Roel1983/RGBW-Bar/README.md

# RGBW-Bar

Work in progress

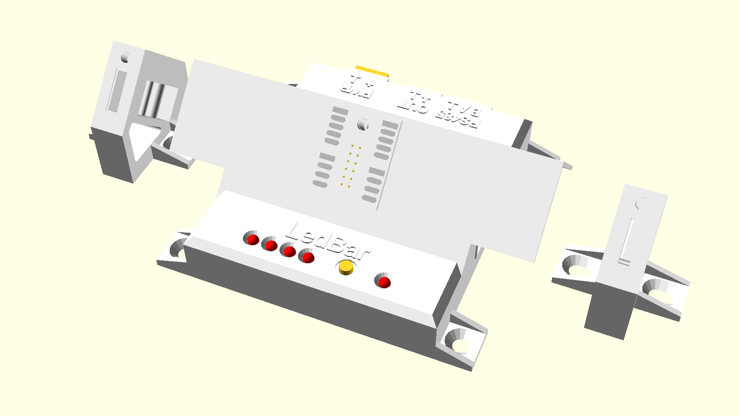
[picture p1: Devices/LedBar/3D/LedBar/LedBar.png]
Case
