Roel1983/RGBW-Bar/Devices/LedBar/3D/LedBar/Case.png

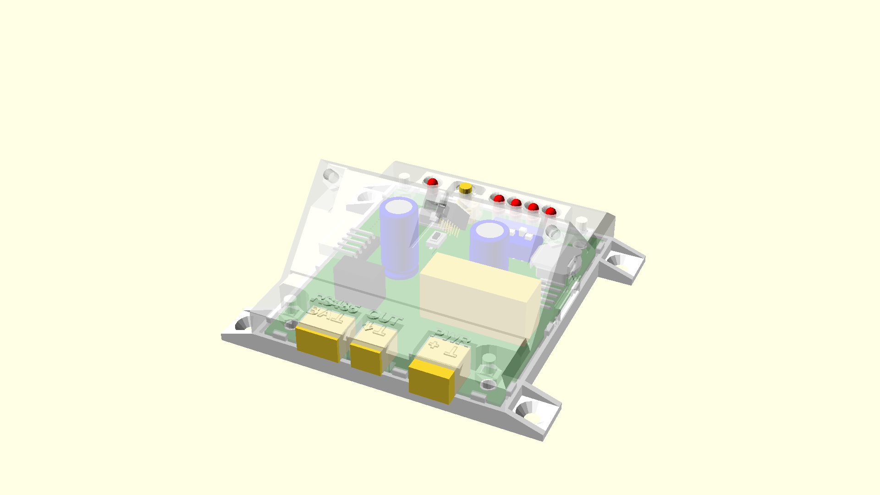
Devices/LedBar/3D/LedBar/Case.png
