Roel1983/RGBW-Bar/Devices/LedBar/3D/LedBar/Case/Shared/Boards/Mainboard/Mainboard.scad

use     <../../../../../../../Shared/3D/Utils/Box.scad>
use     <../../Footprint/Footprint.scad>
use     <../../PlaceFootprints.scad>

include <MainboardKicadPcb.inc>

$fn = 32;
Mainboard();

module Mainboard() {
    MainboardEdgeCuts();
    PlaceFootprints(ALL_COMPONENTS_MAINBOARD, "3D", PCB_THICKNESS_MAINBOARD);
}

module MainboardEdgeCuts() {
    color("green")linear_extrude(PCB_THICKNESS_MAINBOARD) {
        MainboardEdgeCuts2D();
    }
}

module MainboardEdgeCuts2D() {
    difference() {
        Box(bounds = PCB_BOUNDS_MAINBOARD);
        PlaceFootprints(ALL_COMPONENTS_MAINBOARD, "Edge.Cuts");
    }
}
