Roel1983/RGBW-Bar/Devices/LedBar/3D/LedBar/Case/Shared/Footprint/Connector_PinHeader_2_00mm/PinHeader_1x6_P2_00mm_Vertical.scad

include <../../../../Config.inc>

use     <../../../../../../../Shared/3D/Utils/Box.scad>

$fn = 32;

PinHeader_1x6_P2_00mm_Vertical(layer = "3D");

module PinHeader_1x6_P2_00mm_Vertical(layer) {
    if (layer == "3D") {
        Layer3D();
    } else if(layer == "Profile.Remove") {
        LayerProfileRemove();
    }
    pitch = mm(2.00);
    
    module Layer3D() {
        color([.1,.1,.1]) {
            Box(
                x_from = mm(-2.25/2),
                x_size = mm(2.25),
                y_to   = mm(1.25),
                y_size = mm(12.5),
                z_to   = mm(1.5)
            );
        }
        for(y =[-5:0]) {
            translate([0, y * pitch]) {
                Pin();
            }
        }
        
        module Pin() {
            Box(
                x_size = mm(.5),
                y_size = mm(.5),
                z_from = mm(-2.5),
                z_to   = mm(5.5)
            );
        }
    }
    module LayerProfileRemove() {
        BIAS = 0.01;
        Box(
            x_from = mm(-2.25/2),
            x_size = mm(2.25),
            y_to   = mm(1.25),
            y_size = mm(12.5),
            z_from = -BIAS,
            z_to   = mm(1.5)
        );
    }
}
