Roel1983/RGBW-Bar/Devices/LedBar/3D/LedBar/Case/Shared/Footprint/RGBW-Bar/PinHeader_2x06_P200mm_PCB_edge.scad

include <../../../../../../../Shared/3D/Utils/Constants.inc>
include <../../../../Config.inc>
include <../../Boards/Subboards/SubboardsKicadPcb.inc>

use <../Connector_PinHeader_2_00mm/PinHeader_2x6_P2_00mm_Horizontal.scad>

$fn = 32;

PinHeader_2x06_P200mm_PCB_edge(layer = "3D");

module PinHeader_2x06_P200mm_PCB_edge(layer, pins = 3) {
    pitch = mm(2);
    translate([0,0, -pitch / 2 - PCB_THICKNESS_SUBBOARDS / 2])
    rotate(-90, VEC_Y) {
        PinHeader_2x6_P2_00mm_Horizontal(layer);
    }
}
