Roel1983/RGBW-Bar/Devices/Shared/3D/Utils/Hex.scad

Hex(10);

module Hex(size = 1) {
    intersection_for(a=[0:120:359]) rotate(a) {
        square([size, 2 * size], true);
    }
}
