Roel1983/RGBW-Bar/Devices/Shared/3D/Utils/Optional.scad

function optional(o, def) = is_undef(o) ? def : o;

assert(optional(undef,      "default") == "default");
assert(optional("my_value", "default") == "my_value");
