Roel1983/RGBW-Bar/Devices/Shared/3D/Utils/TransformCopy.scad

module mirror_copy(vec) {
    children();
    mirror(vec) children();
}
