Roel1983/RGBW-Bar/Devices/LedBar/3D/LedBar/Support/EndSupportAngle45.scad

use <EndSupportStraight.scad>

EndSupportAngle45();

module EndSupportAngle45() {
    EndSupportStraight(45);
}
