Roel1983/RGBW-Bar/Devices/LedBar/3D/LedBar/Case/Shared/Footprint/Button_Switch_SMD/Button_Switch_SMD.scad

use <SW_SPST_CK_RS282G05A3.scad>

module Button_Switch_SMD(layer, footprint) {
    if(footprint == "SW_SPST_CK_RS282G05A3") {
        SW_SPST_CK_RS282G05A3(layer = layer);
    }
}
