Roel1983/RGBW-Bar/Devices/LedBar/3D/LedBar/Case/Shared/Footprint/Button_Switch_SMD/SW_SPST_CK_RS282G05A3.scad

use     <../../../../../../../Shared/3D/Utils/Units.scad>

SW_SPST_CK_RS282G05A3(layer = "3D");

module SW_SPST_CK_RS282G05A3(layer) {
    if (layer == "3D") {
        Layer3D();
    }
    
    module Layer3D() {
        color("silver") {
            linear_extrude(mm(0.15)) square(mm([8.0, nozzle(2)]), center=true);
            linear_extrude(mm(1.35)) square(mm([6.0, 3.6]), center=true);
            linear_extrude(mm(1.70)) square(mm([4.0, 2.0]), center=true);
        }
        color([0.1,0.1,0.1]) {
            linear_extrude(mm(2.30)) square(mm([2.65, 1.3]), center=true);
        }
    }
}
