Roel1983/RGBW-Bar/Devices/LedBar/3D/LedBar/Case/Shared/Footprint/Button_Switch_THT/Button_Switch_THT.scad

use <../../../../../../../Shared/3D/Utils/Units.scad>

use <SW_DIP_SPSTx05_Slide_6_7x14_26mm_W7_62mm_P2_54mm_LowProfile.scad>
use <SW_PUSH_6mm.scad>

module Button_Switch_THT(layer, footprint) {
    if(footprint == "SW_PUSH_6mm_H8mm") {
        SW_PUSH_6mm(layer = layer, H=mm(10.0));
    } else if(footprint == "SW_DIP_SPSTx05_Slide_6.7x14.26mm_W7.62mm_P2.54mm_LowProfile") {
        SW_DIP_SPSTx05_Slide_6_7x14_26mm_W7_62mm_P2_54mm_LowProfile(layer = layer, channels = 5);
    }
}
