Roel1983/RGBW-Bar/Devices/LedBar/3D/LedBar/Case/Shared/Footprint/Capacitor_SMD/Capacitor_SMD.scad

use <C_0805_2012Metric_Pad1_18x1_45mm_HandSolder.scad>

module Capacitor_SMD(layer, footprint) {
    if(footprint == "C_0805_2012Metric_Pad1.18x1.45mm_HandSolder") {
        C_0805_2012Metric_Pad1_18x1_45mm_HandSolder(layer);
    }
}
