Roel1983/RGBW-Bar/Devices/LedBar/3D/LedBar/Case/Shared/Footprint/Connector_PinHeader_2_00mm/RGBW_wire_solder_pads.scad

use     <../../../../../../../Shared/3D/Utils/Box.scad>
use     <../../../../../../../Shared/3D/Utils/Units.scad>

RGBW_wire_solder_pads(layer = "3D", side = "R");

module RGBW_wire_solder_pads(layer, side) {
    if (layer == "3D") {
        Layer3D();
    }
    
    module Layer3D() {
        color("silver") {
            pitch = mm(2.0);
            linear_extrude(layer(1)) {
                PinRectangle();
                for(i=[1:4]) translate([0, -i * pitch]) {
                    PinOval();
                }
            }
        }
        
        module PinRectangle() {
            Box(x_size = mm(4.05), y_size = mm(1.4));
        }
        
        module PinOval() {
            hull() {
                translate([-mm((4.05 - 1.4) / 2 ), 0]) circle(d=mm(1.4));
                translate([ mm((4.05 - 1.4) / 2 ), 0]) circle(d=mm(1.4));
            }
        }
    }
}
