Roel1983/RGBW-Bar/Devices/LedBar/3D/LedBar/Case/Shared/Footprint/Crystal/Crystal_C38_LF_Horizontal_1EP_style1.scad

include <../../../../../../../Shared/3D/Utils/Constants.inc>
use     <../../../../../../../Shared/3D/Utils/Units.scad>
$fn = 32;

Crystal_C38_LF_Horizontal_1EP_style1(layer = "3D", D=mm(3.0), L=mm(8.0));

module Crystal_C38_LF_Horizontal_1EP_style1(layer, D=mm(3.0), L=mm(8.0)) {
    if (layer == "3D") {
        Layer3D();
    }
    
    module Layer3D() {
        color("silver") {
            pitch = mm(1.9);
            translate([0, mm(-2.3), D/2])
            rotate(90, VEC_X) cylinder(d=D, h=L);
        }
    }
}
