Roel1983/RGBW-Bar/Devices/LedBar/3D/LedBar/Case/Shared/Footprint/Diode_SMD/Diode_SMD.scad

use     <../../../../../../../Shared/3D/Utils/Units.scad>

use <D_SMB_Handsoldering.scad>

module Diode_SMD(layer, footprint) {
    if(footprint == "D_SMB_Handsoldering") {
        D_SMB_Handsoldering(layer = layer);
    }
}
