Roel1983/RGBW-Bar/Devices/LedBar/3D/LedBar/Case/Shared/Footprint/Jumper/Jumper.scad

use     <../../../../../../../Shared/3D/Utils/Units.scad>

use <SolderJumper_3_P1_3mm_Open_Pad1_0x1_5mm.scad>

module Jumper(layer, footprint) {
    if(footprint == "SolderJumper-3_P1.3mm_Open_Pad1.0x1.5mm") {
        SolderJumper_3_P1_3mm_Open_Pad1_0x1_5mm(layer = layer);
    }
}
