Roel1983/RGBW-Bar/Devices/LedBar/3D/LedBar/Case/Shared/Footprint/MountingHole/MountingHole.scad

use <MountingHole_4_3mm_M4.scad>

module MountingHole(layer, footprint) {
    if(footprint == "MountingHole_4.3mm_M4") {
        MountingHole_4_3mm_M4(layer = layer);
    }
}
