Roel1983/RGBW-Bar/Devices/LedBar/3D/LedBar/Case/Shared/Footprint/MountingHole/MountingHole_4_3mm_M4.scad

use     <../../../../../../../Shared/3D/Utils/Units.scad>

MountingHole_4_3mm_M4(layer = "Edge.Cuts");

module MountingHole_4_3mm_M4(layer) {
    if(layer == "Edge.Cuts") {
        EdgeCuts();
    }
    
    module EdgeCuts() {
        circle(d = mm(4.3));
    }
}
