Roel1983/RGBW-Bar/Devices/LedBar/3D/LedBar/Case/Shared/Footprint/Resistor_SMD/R_0805_2012Metric_Pad1_20x1_40mm_HandSolder.scad

use     <../../../../../../../Shared/3D/Utils/Units.scad>

use <R_HandSolder.scad>

R_0805_2012Metric_Pad1_20x1_40mm_HandSolder("3D");

module R_0805_2012Metric_Pad1_20x1_40mm_HandSolder(layer = "3D") {
    R_HandSolder(
        layer = layer,
        l = inch(0.08),
        w = inch(0.05),
        h = mm(0.45),
        
        solder_l = mm(3.2),
        solver_w = mm(1.4)
    );
}
