Roel1983/RGBW-Bar/Devices/LedBar/3D/LedBar/Case/Shared/Footprint/Resistor_SMD/R_1210_3225Metric_Pad1_30x2_65mm_HandSolder.scad

use     <../../../../../../../Shared/3D/Utils/Units.scad>

use <../Shared/SMD_HandSolder.scad>

R_1210_3225Metric_Pad1_30x2_65mm_HandSolder("3D");

module R_1210_3225Metric_Pad1_30x2_65mm_HandSolder(layer = "3D") {
    SMD_HandSolder(
        layer = layer,
        l = inch(0.12),
        w = inch(0.10),
        h = mm(0.55),
        
        solder_l = mm(1.55 * 2 + 1.3) ,
        solder_w = mm(2.65)
    );
}
