Roel1983/RGBW-Bar/(list of files, cad)

Other CAD files:
Devices/LedBar/3D/LedBar/Case/Shared/Footprint/Connector_PinHeader_2_00mm/PinHeader_2x6_P2_00mm_Vertical.scad
Devices/Shared/3D/Utils/Shapes.scad
Devices/LedBar/3D/LedBar/Support/MiddleSupport.scad
Devices/LedBar/3D/LedBar/Support/MiddleSupportTemplate.scad
Devices/LedBar/3D/LedBar/Case/Shared/Footprint/RGBW-Bar/15EDGRC_3_5.scad
Devices/LedBar/3D/LedBar/Case/Shared/Footprint/RGBW-Bar/2EDGRC_5_08_2P.scad
Devices/LedBar/3D/LedBar/Case/Shared/Footprint/RGBW-Bar/B0505S_1W.scad
Devices/LedBar/3D/LedBar/Case/Shared/Footprint/RGBW-Bar/Color_wire_solder_pads.scad
Devices/LedBar/3D/LedBar/Case/Shared/Footprint/RGBW-Bar/Fuseholder_Cylinder_5x20mm_BLX_A_Horizontal.scad
Devices/LedBar/3D/LedBar/Case/Shared/Footprint/RGBW-Bar/ISP_single_row.scad
Devices/LedBar/3D/LedBar/Case/Shared/Footprint/RGBW-Bar/MountingHole_3_2mm_Wall_0_8mm.scad
Devices/LedBar/3D/LedBar/Case/Shared/Footprint/RGBW-Bar/MountingHole_4_3mm_M4_modified1.scad
Devices/LedBar/3D/LedBar/Case/Shared/Footprint/RGBW-Bar/Perpendicular_pcb_1mm_female_2x6.scad
Devices/LedBar/3D/LedBar/Case/Shared/Footprint/RGBW-Bar/RGBW-Bar.scad
Devices/LedBar/3D/LedBar/Case/Shared/Footprint/RGBW-Bar/TestPoint_Pad.scad
Devices/LedBar/3D/LedBar/Case/Shared/Footprint/Resistor_SMD/R_HandSolder.scad
Devices/LedBar/3D/LedBar/Case/Shared/Footprint/Resistor_SMD/Resistor_SMD.scad
Devices/LedBar/3D/LedBar/Case/Shared/Footprint/Shared/SMD_HandSolder.scad
