Roel1983/RGBW-Bar/(threads)

Thread 1 (2022-09-15):

Fix color channel order of strips

Roel1983, 2022-09-15:
Should be:

RGB-strip
1 : 12V
2 : B
3 : R
4 : G

RGBW-strip
1 : 12V
2 : R
3 : G
4 : B
5 : W

To minimize crossing lines the main connector:
1 : 12V
2 : R
3 : G
4 : B
5 : W

Roel1983, 2022-10-29:
- [ ] Make sure for the last time we have the order correct now? (Don't trust the Chinese silklayer)
- [ ] Create new foot prints with the correct channel order
- [ ] Make new symbols with the correct channel order for the main connector
- [ ] Rewire the connectors in the schematic
- [ ] Rewire the connectors on the PCB

Roel1983, 2022-10-30:
The left sided RGB(W) connectors are at the right side and visa versa, because they are 180 degrees rotated.

Closed 2022-10-30.

Thread 10 (2022-09-15):

Add clearance around screw holes

Roel1983, 2022-09-15:

Closed 2022-11-17.

Thread 11 (2022-09-15):

PCB: Make 'Left' and 'Right' board identical

Roel1983, 2022-09-15:
By making them identical it is less cost to manufacture.

Roel1983, 2022-11-04:
Just remove reference numbers of silk screen and other silkscreen that is specific for the left versus the right board.

Closed 2022-11-13.

Thread 12 (2022-09-15):

3D: Update case for changes to the PCB

Roel1983, 2022-09-15:
Adjust for change of E.g.:
- [ ] #4
- [ ] perpendicular board shape
- [ ] PCB thickness
- [ ] Holes
- [ ] Feet
- [ ] Wall thickness

Roel1983, 2023-07-25:
N.a. Applies to out-dated version of the case

Closed 2023-07-25.

Thread 2 (2022-09-15):

PCB: Improve brown-out threshold

Roel1983, 2022-09-15:

Roel1983, 2023-07-25:
Done by now

Closed 2023-07-25.

Thread 4 (2022-09-15):

Replace power connector for bigger connector

Roel1983, 2022-09-15:

Roel1983, 2022-10-31:
Replaced connector footprint 15EDGRC-3.5 for 2EDGRC-5.08 connectors.
Updated schematic
Updated PCB

Closed 2022-10-31.

Thread 5 (2022-09-15):

Inverse brown-out LED.

Roel1983, 2022-09-15:

Closed 2022-10-31.

Thread 6 (2022-09-15):

Fix shape of perpendicular board so it corresponds with width of J1002

Roel1983, 2022-09-15:

Roel1983, 2022-11-02:
I measured the connector at 12.5mm width and updated the board-outline by rounding of to 12.57mm
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

Closed 2022-11-02.

Thread 8 (2022-09-15):

Fix 5V power suppy so it doesn't fail dangerously

Roel1983, 2022-09-15:
Suggestions:
- place an series resistor to the LDO
- add optional zener diode
- Use branded LDO instead of Chinees unbranded stuff
- Check data sheet for e.g. type of capacitor to use

Closed 2022-11-01.

Thread 13 (2022-10-30):

Disable LED when at power up until initialization is complete

Roel1983, 2022-10-30:
We need an extra pin that is pulled up and connected to the ~oe~ using a diode.
When the pin is initially an input, the pull-up will raise it. It has to be actively lowered by making it an output and set to LOW. The diode makes it possible the rest of the circuit keeps working.

Roel1983, 2022-10-31:
Pin 'dbg2' is now '~pca_rdy~' is pulled up by an external resistor.
ISP connector is moved downwards to make space for extra components
a GND test-pin pad is moved to other location

Closed 2022-10-31.

Thread 14 (2022-10-31):

3D: Add screw feet to main enclosure

Roel1983, 2022-10-31:
Lets use the screw holes at all corners of the PCB for metric screws to close the enclosure and at feet for the mounting screws.
Rational: no sharp screws that might cut into the PCB. Better closing of the enclosure.

Roel1983, 2023-07-25:
N.a. Applies to out-dated version of the case

Closed 2023-07-25.

Thread 17 (2022-11-02):

3D: Add optional aditional nuts in the enclosure to screw on the profile

Roel1983, 2022-11-02:
Add 2 nuts like already done for securing the center-board and profile with the enclose.
Locate those nuts at either sides and a the other slanted surface as the nut for the center-board.
- [ ] Add nuts to the enclosure
- [ ] Make/update drill fixtures

Roel1983, 2023-07-25:
N.a. Applies to out-dated version of the case

Closed 2023-07-25.

Thread 23 (2022-11-17):

PCB: Fix copper layer unprotected_12VDC

Roel1983, 2022-11-17:

Closed 2022-11-17.

Thread 25 (2023-07-20):

3D: Add more tolerance around LED

Roel1983, 2023-07-20:

Closed 2023-07-20.

Thread 26 (2023-07-20):

3D: Add more tolerance around button

Roel1983, 2023-07-20:

Closed 2023-07-25.

Thread 27 (2023-07-20):

3D: Add tolerance to mainboard PCB thickness

Roel1983, 2023-07-20:

Thread 28 (2023-07-20):

3D: Add more z tolerance to back connectors

Roel1983, 2023-07-20:

Roel1983, 2023-07-31:
Solved

Closed 2023-07-31.

Thread 30 (2023-07-25):

3D: Inner rim to hole for J1005

Roel1983, 2023-07-25:

Roel1983, 2023-07-31:
Solved

Closed 2023-07-31.

Thread 31 (2023-07-27):

3D: Side connector too tight

Roel1983, 2023-07-27:

Roel1983, 2023-07-31:
Solved

Closed 2023-07-31.
