Roel1983/RGBW-Bar/Devices/LedBar/PCB/Release/LedBar.pdf

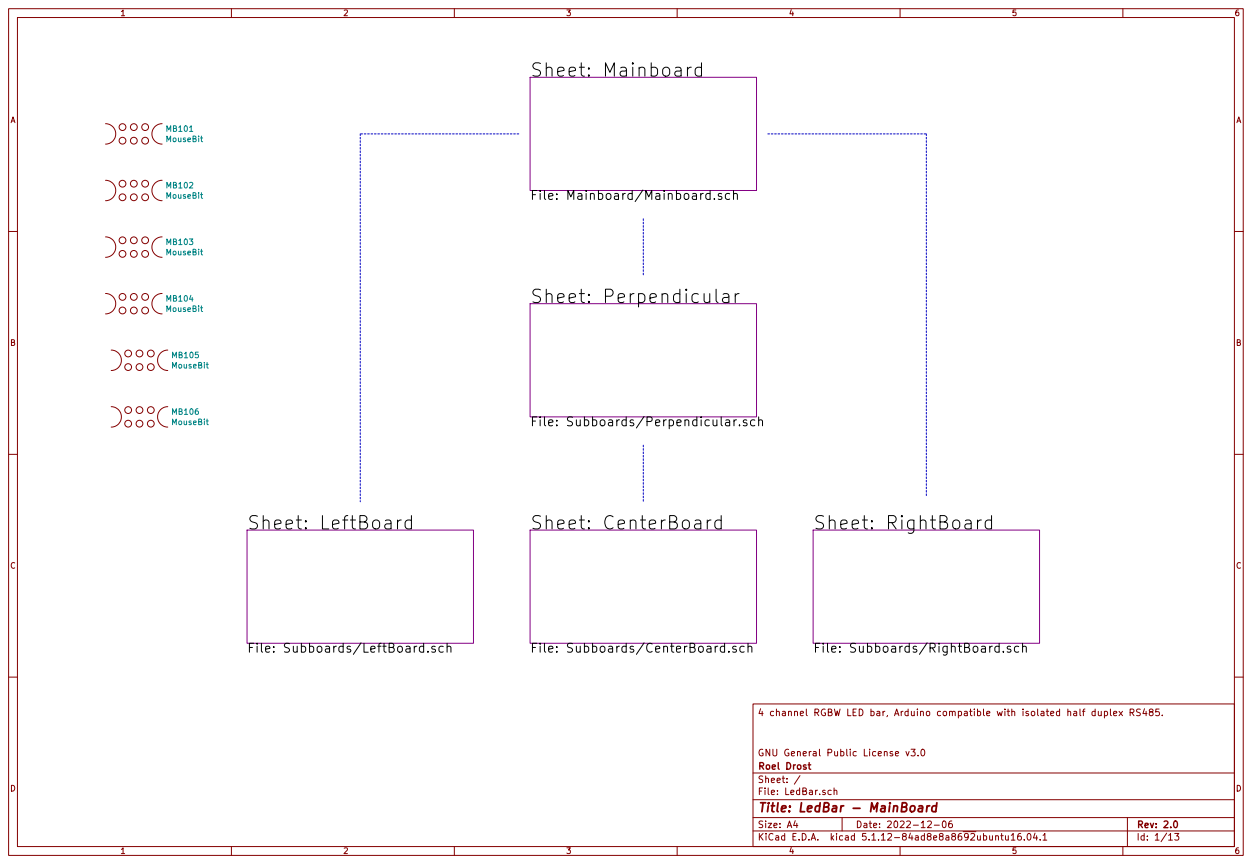
[picture p3: page 1]

MB106 MouseBit MB105 MouseBit MB104 MouseBit MB103 MouseBit MB102 MouseBit MB101 MouseBit

File: Mainboard/Mainboard.sch

File: Subboards/Perpendicular.sch

File: Subboards/LeftBoard.sch

File: Subboards/CenterBoard.sch

File: Subboards/RightBoard.sch

4 channel RGBW LED bar, Arduino compatible with isolated half duplex RS485.

File: LedBar.sch Sheet: / Roel Drost GNU General Public License v3.0

Id: 1/13 Title: LedBar - MainBoard

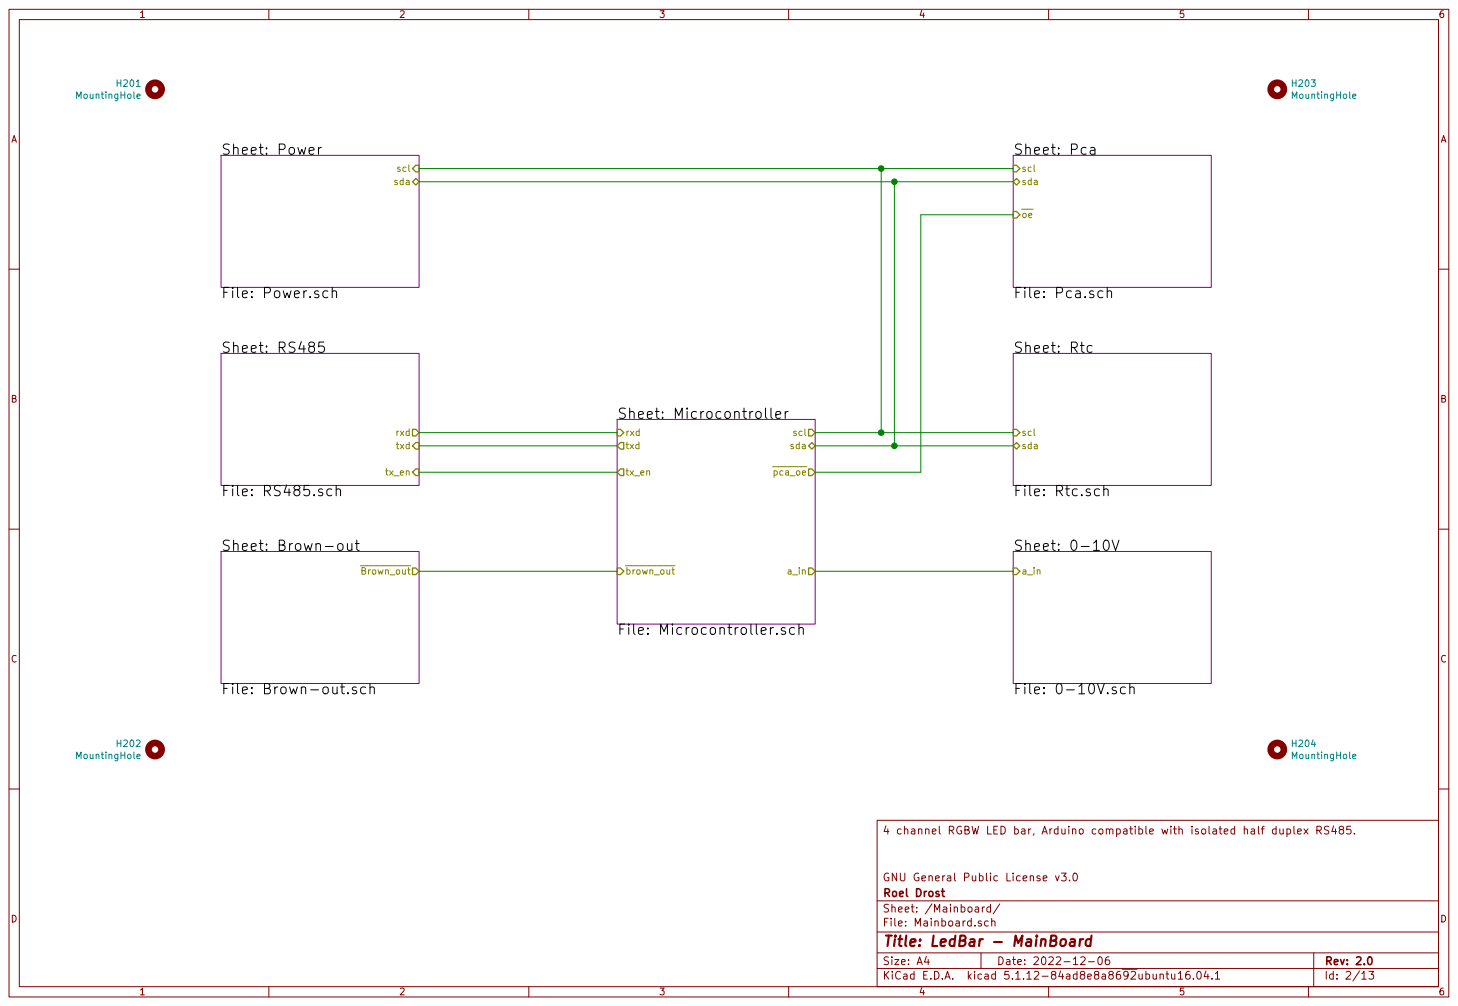
[picture p4: page 2]

File: Brown-out.sch

4 channel RGBW LED bar, Arduino compatible with isolated half duplex RS485.

File: Mainboard.sch Sheet: /Mainboard/ Roel Drost GNU General Public License v3.0

Id: 2/13 Title: LedBar - MainBoard

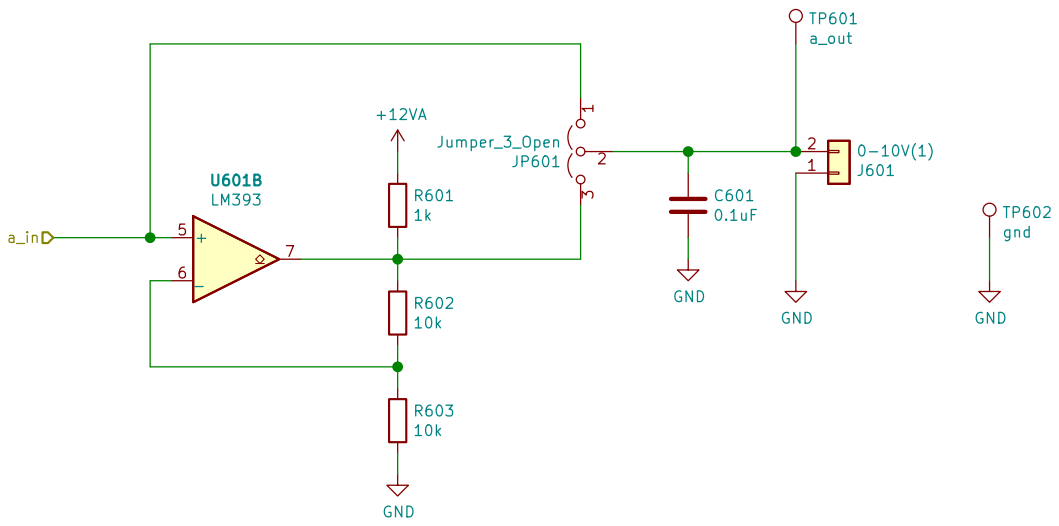
[picture p5: page 3]

4 channel RGBW LED bar, Arduino compatible with isolated half duplex RS485. R601
0.1uF GND

File: 0-10V.sch Sheet: /Mainboard/0-10V/ Roel Drost GNU General Public License v3.0

Id: 3/13 Title: LedBar - MainBoard

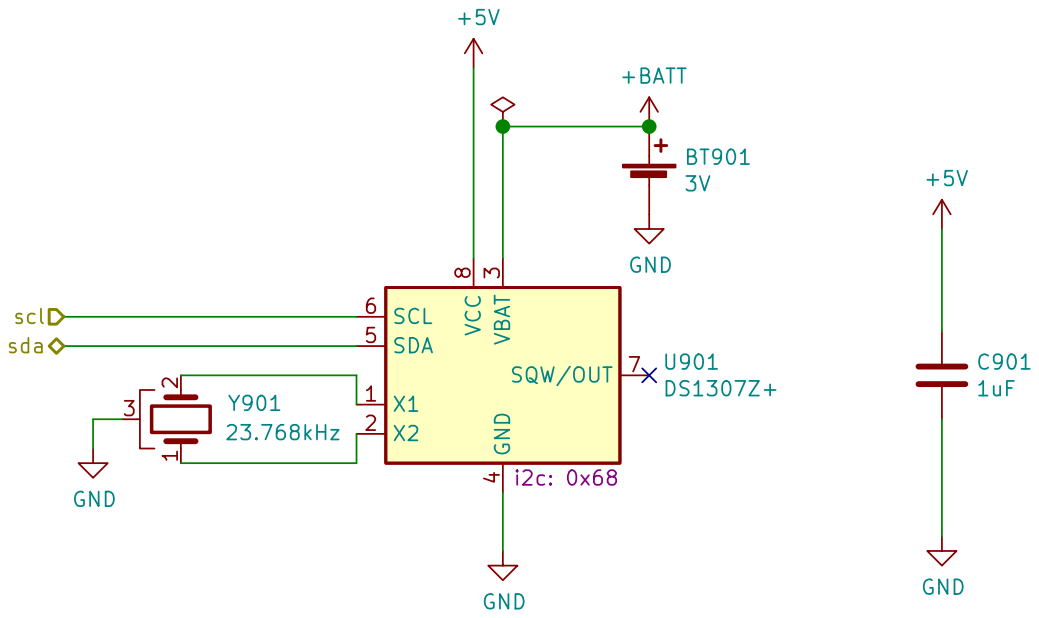
[picture p6: page 4]

4 SDA 5 SCL 6 SQW/OUT 7 VCC

4 channel RGBW LED bar, Arduino compatible with isolated half duplex RS485.

File: Rtc.sch Sheet: /Mainboard/Rtc/ Roel Drost GNU General Public License v3.0

Id: 4/13 Title: LedBar - MainBoard

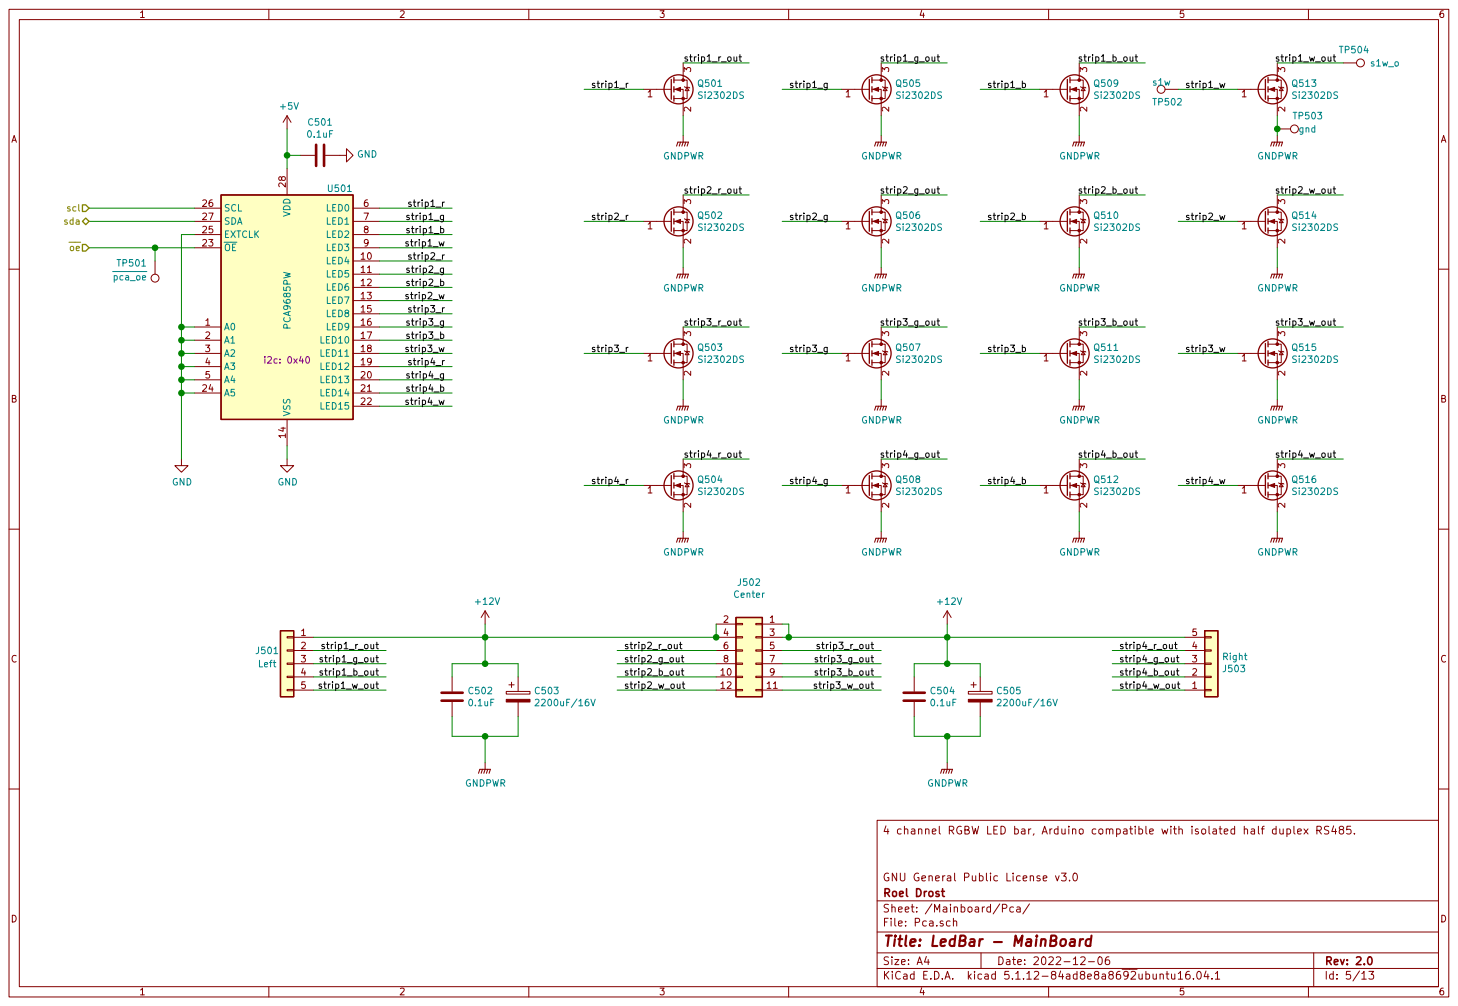
[picture p7: page 5]

4 channel RGBW LED bar, Arduino compatible with isolated half duplex RS485. GNDPWR

File: Pca.sch Sheet: /Mainboard/Pca/ Roel Drost GNU General Public License v3.0

Id: 5/13 Title: LedBar - MainBoard

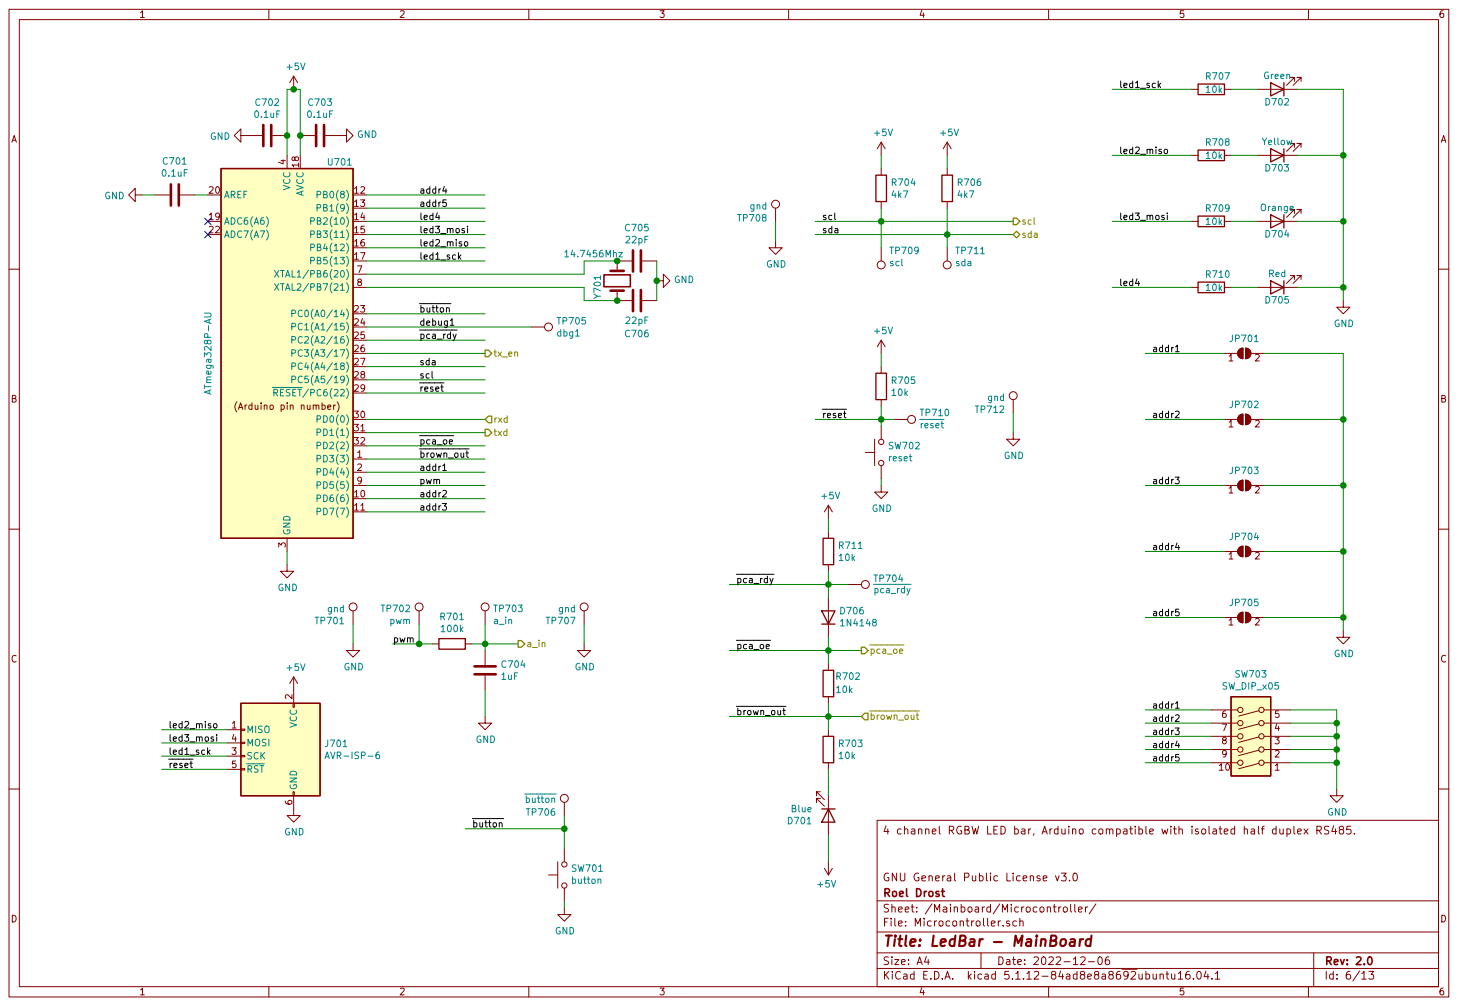
[picture p8: page 6]

4 channel RGBW LED bar, Arduino compatible with isolated half duplex RS485.

File: Microcontroller.sch Sheet: /Mainboard/Microcontroller/ Roel Drost GNU General Public License v3.0

Id: 6/13 Title: LedBar - MainBoard

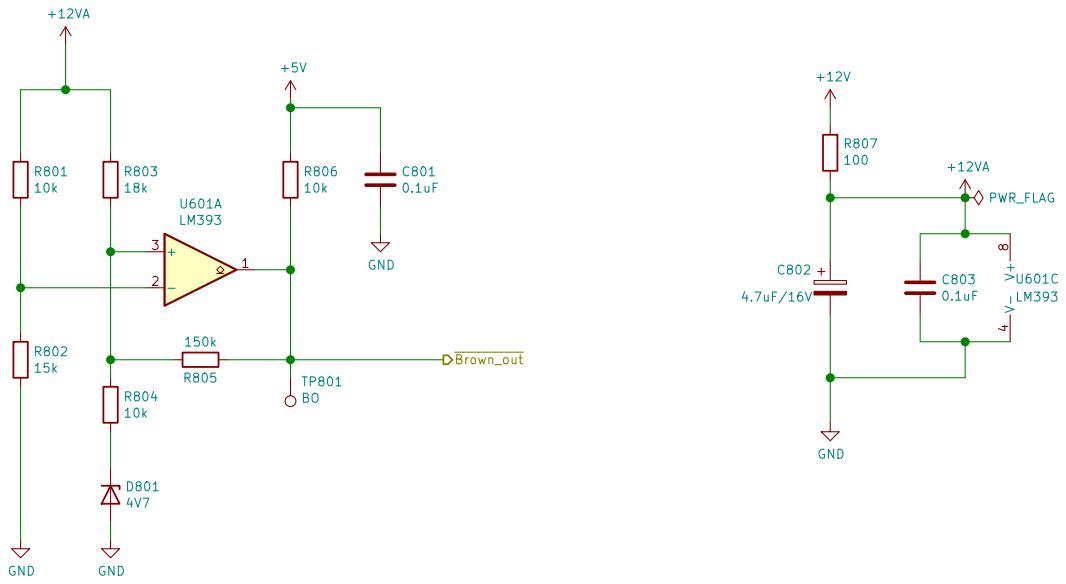
[picture p9: page 7]

4 channel RGBW LED bar, Arduino compatible with isolated half duplex RS485. R807

File: Brown-out.sch Sheet: /Mainboard/Brown-out/ Roel Drost GNU General Public License v3.0

Id: 7/13 Title: LedBar - MainBoard

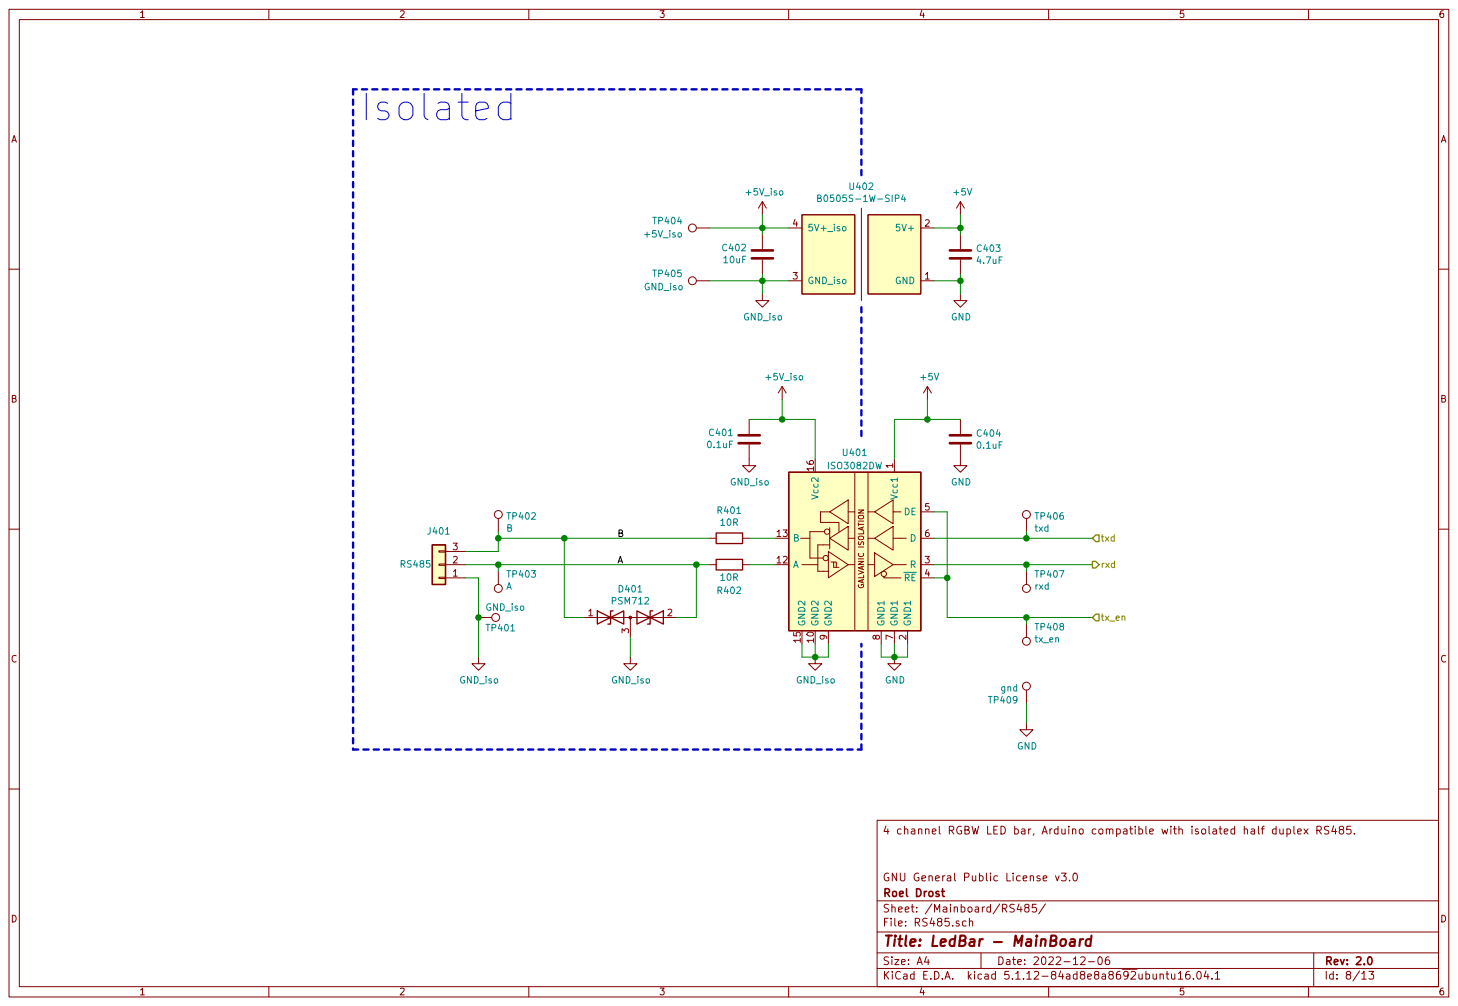
[picture p10: page 8]

File: RS485.sch Sheet: /Mainboard/RS485/ Roel Drost GNU General Public License v3.0

Id: 8/13 Title: LedBar - MainBoard

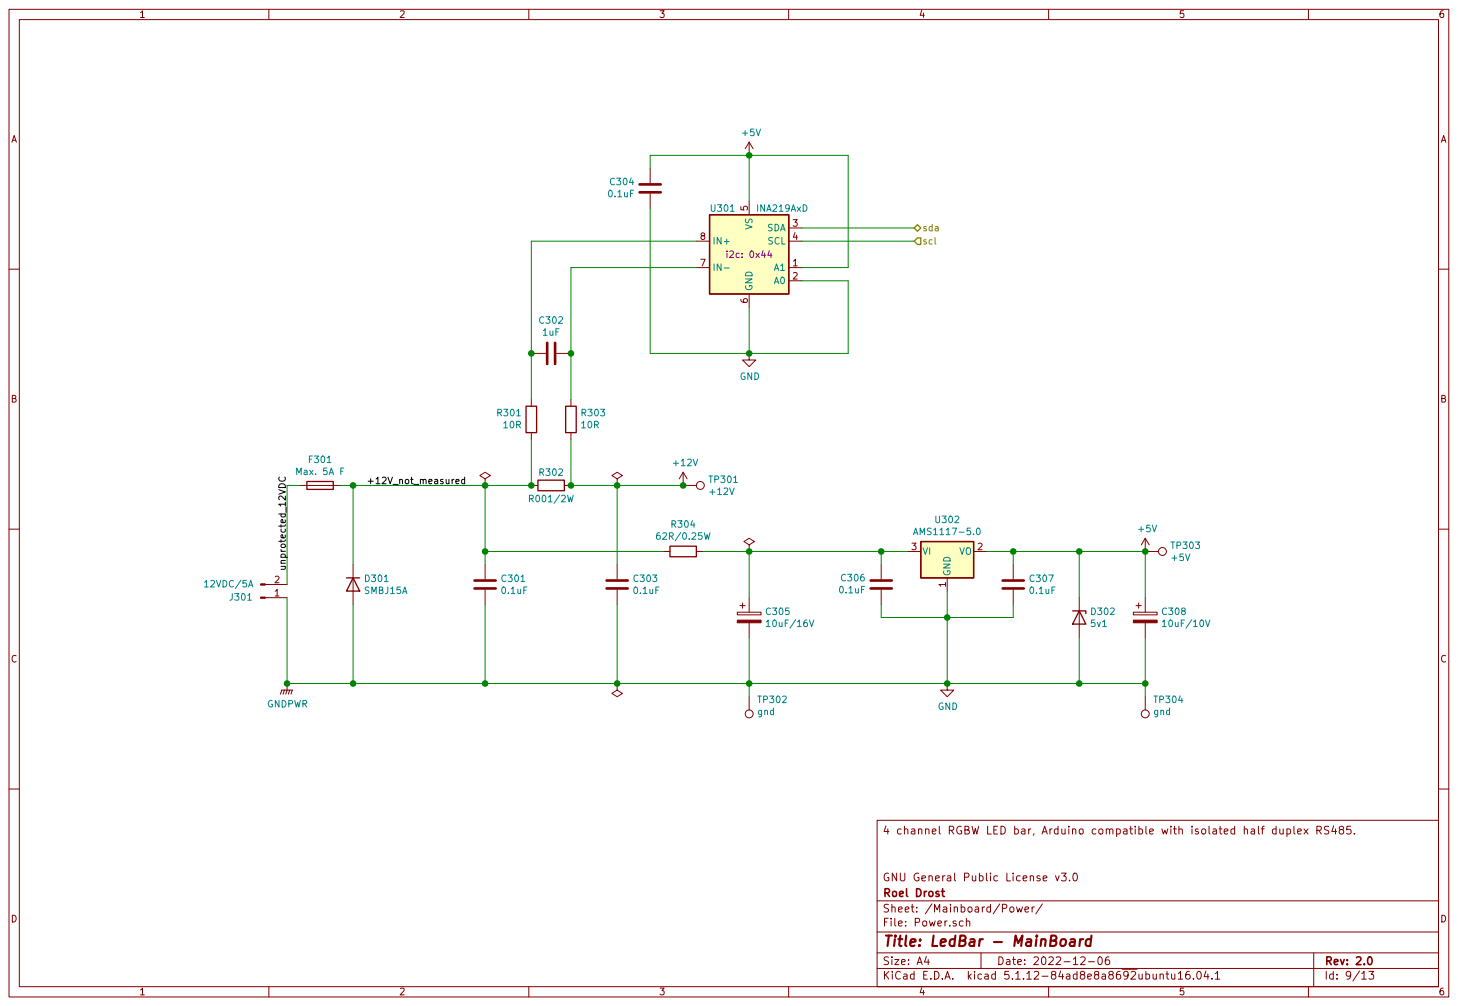
[picture p11: page 9]

4 channel RGBW LED bar, Arduino compatible with isolated half duplex RS485. GND

File: Power.sch Sheet: /Mainboard/Power/ Roel Drost GNU General Public License v3.0

Id: 9/13 Title: LedBar - MainBoard

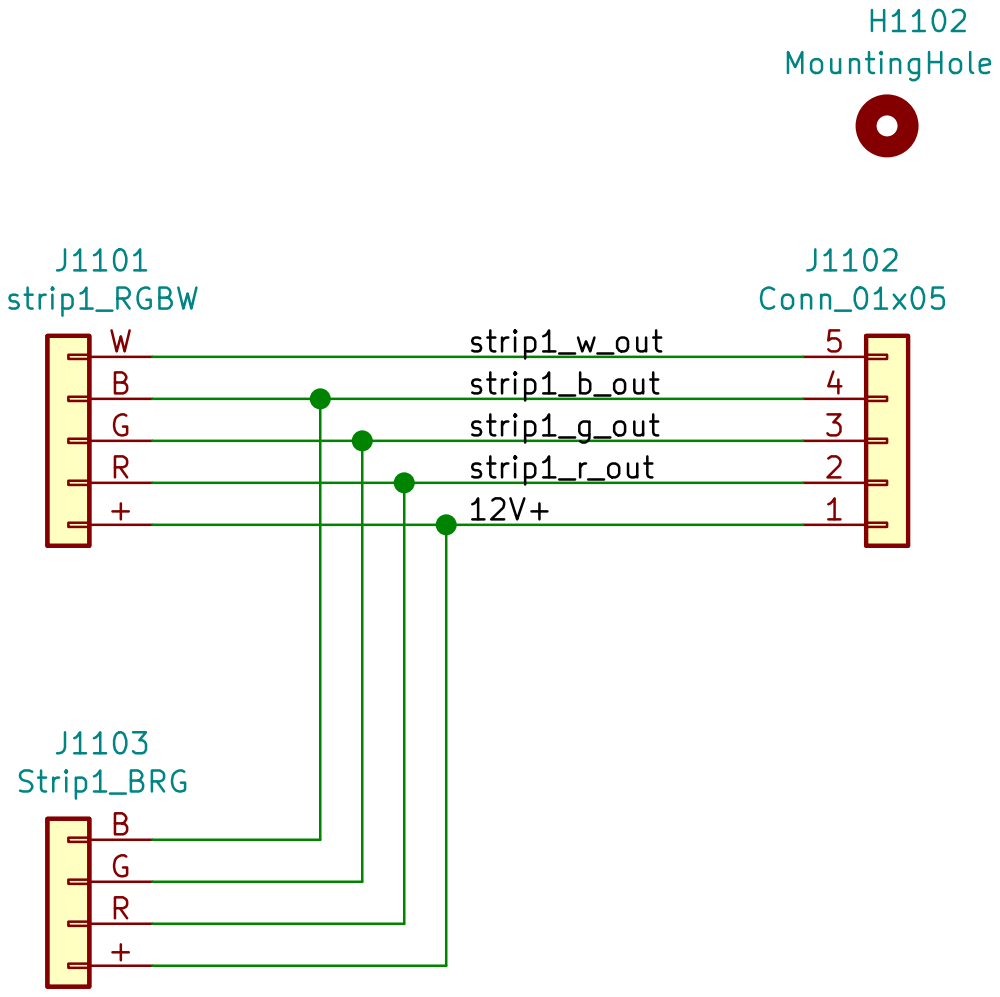
[picture p12: page 10]

strip1_g_out 3
strip1_r_out 2

4 channel RGBW LED bar, Arduino compatible with isolated half duplex RS485.

File: LeftBoard.sch Sheet: /LeftBoard/ Roel Drost GNU General Public License v3.0

Id: 10/13 Title: LedBar - MainBoard

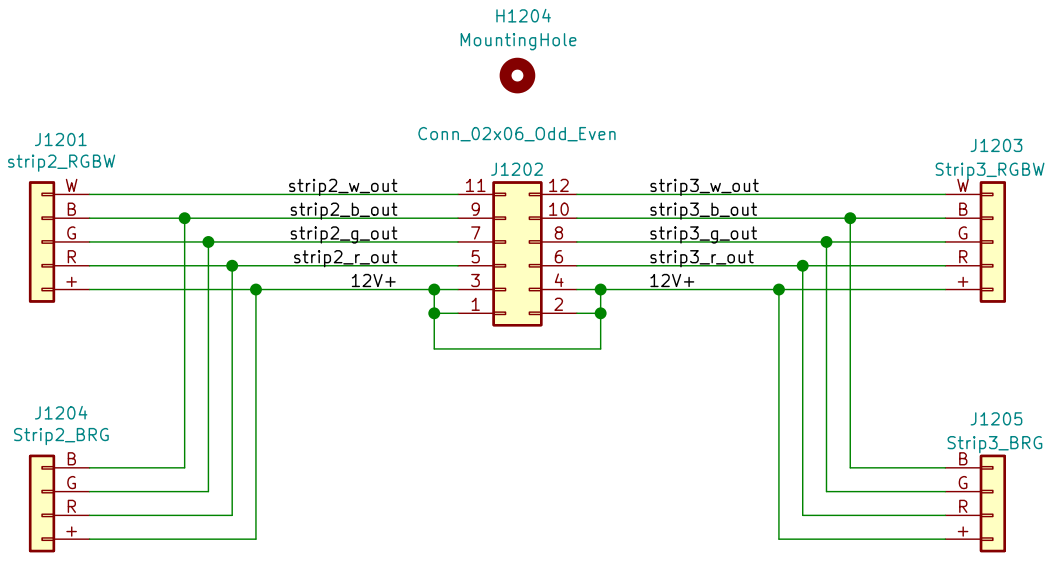
[picture p13: page 11]

+BG | strip2_g_out 7 | | 8 | +BG

strip2_b_out 9 | | 10 strip3_b_out

5 | | strip3_g_out 12V+ 6 strip3_r_out

4 channel RGBW LED bar, Arduino compatible with isolated half duplex RS485.

File: CenterBoard.sch Sheet: /CenterBoard/ Roel Drost GNU General Public License v3.0

Id: 11/13 Title: LedBar - MainBoard

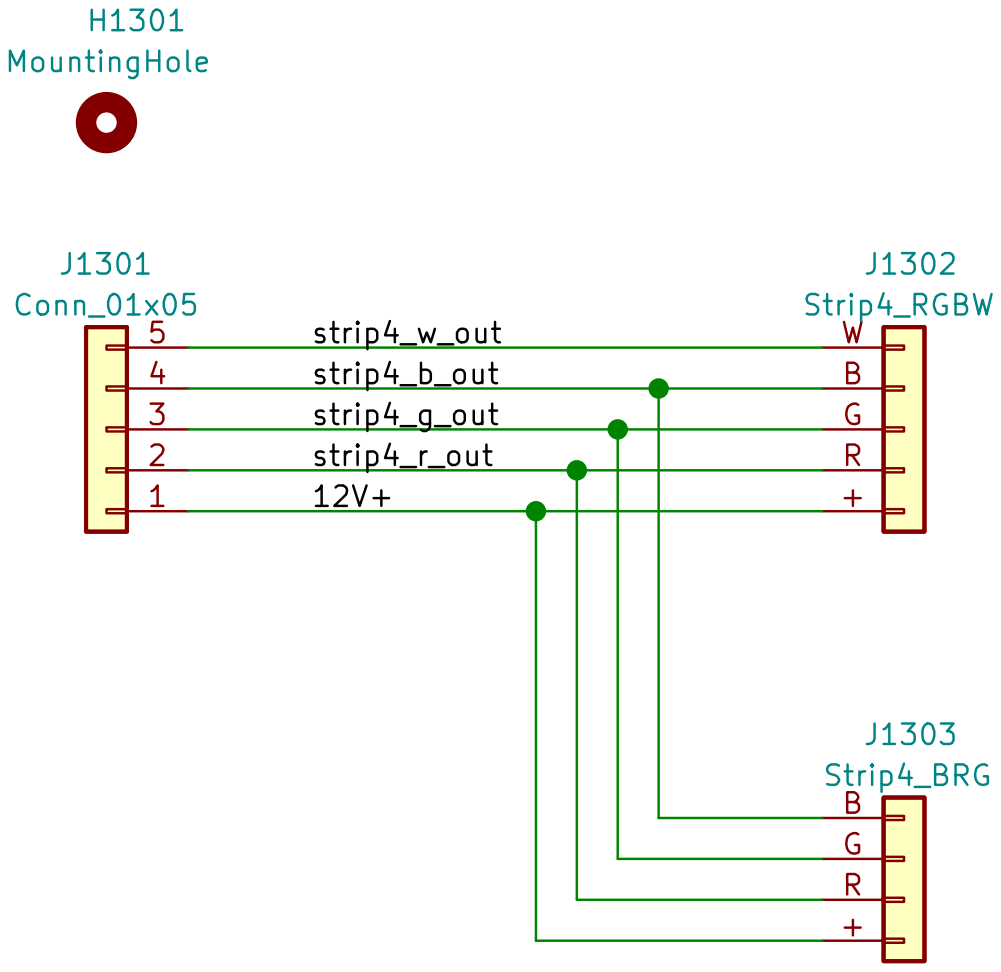
[picture p14: page 12]

3 | +BG
strip4_g_out 12V+ 2 strip4_r_out

J1303 Strip4_BRG
4 channel RGBW LED bar, Arduino compatible with isolated half duplex RS485. +BG

Sheet: /RightBoard/ Roel Drost GNU General Public License v3.0

File: RightBoard.sch
Id: 12/13 Title: LedBar - MainBoard

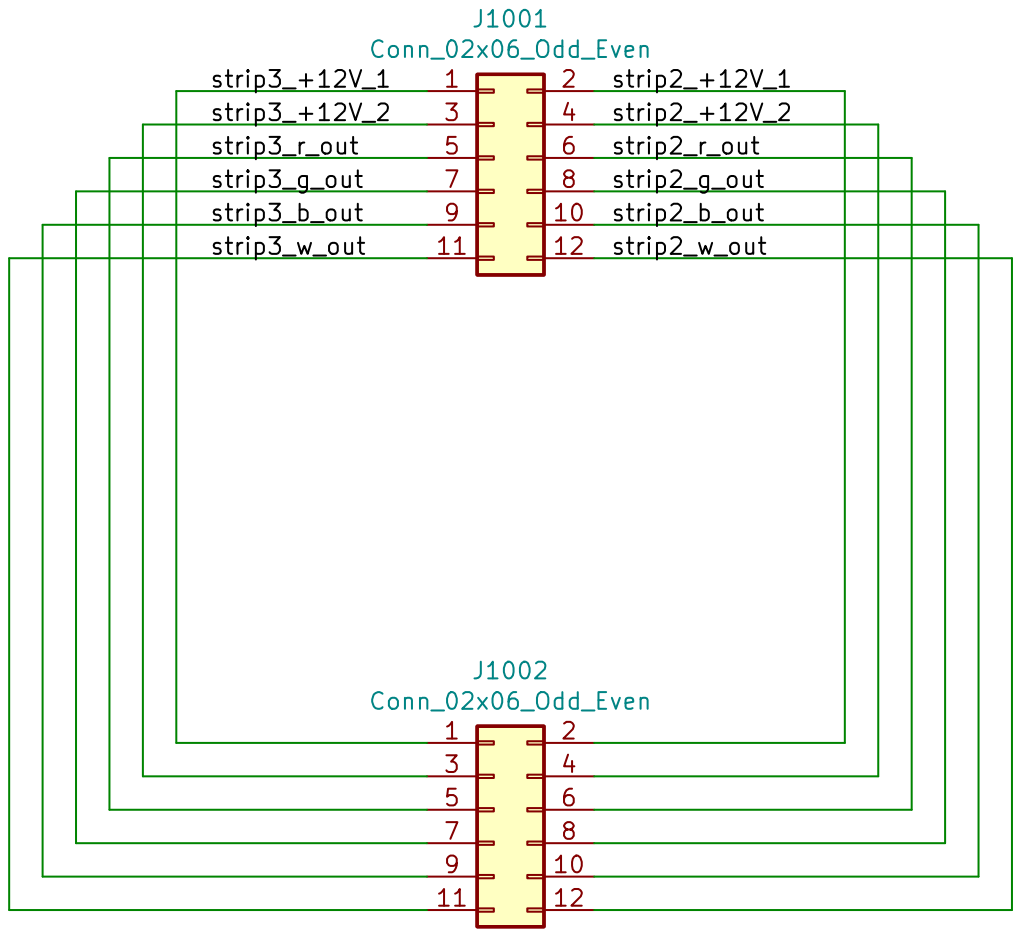
[picture p15: page 13]

strip3_+12V_2 3 | | 4 strip2_+12V_2
strip3_r_out 5 | | 6 strip2_r_out
strip3_g_out 7 | | 8 strip2_g_out
strip3_b_out 9 | | 10 strip2_b_out
strip3_w_out 11 | | 12 strip2_w_out

J1002 Conn_02x06_Odd_Even
4 channel RGBW LED bar, Arduino compatible with isolated half duplex RS485. 1

Sheet: /Perpendicular/ Roel Drost GNU General Public License v3.0

File: Perpendicular.sch
Id: 13/13 Title: LedBar - MainBoard
