Roel1983/RGBW-Bar/Devices/RS485-TTL/PCB/Release/RS485-TTL.pdf

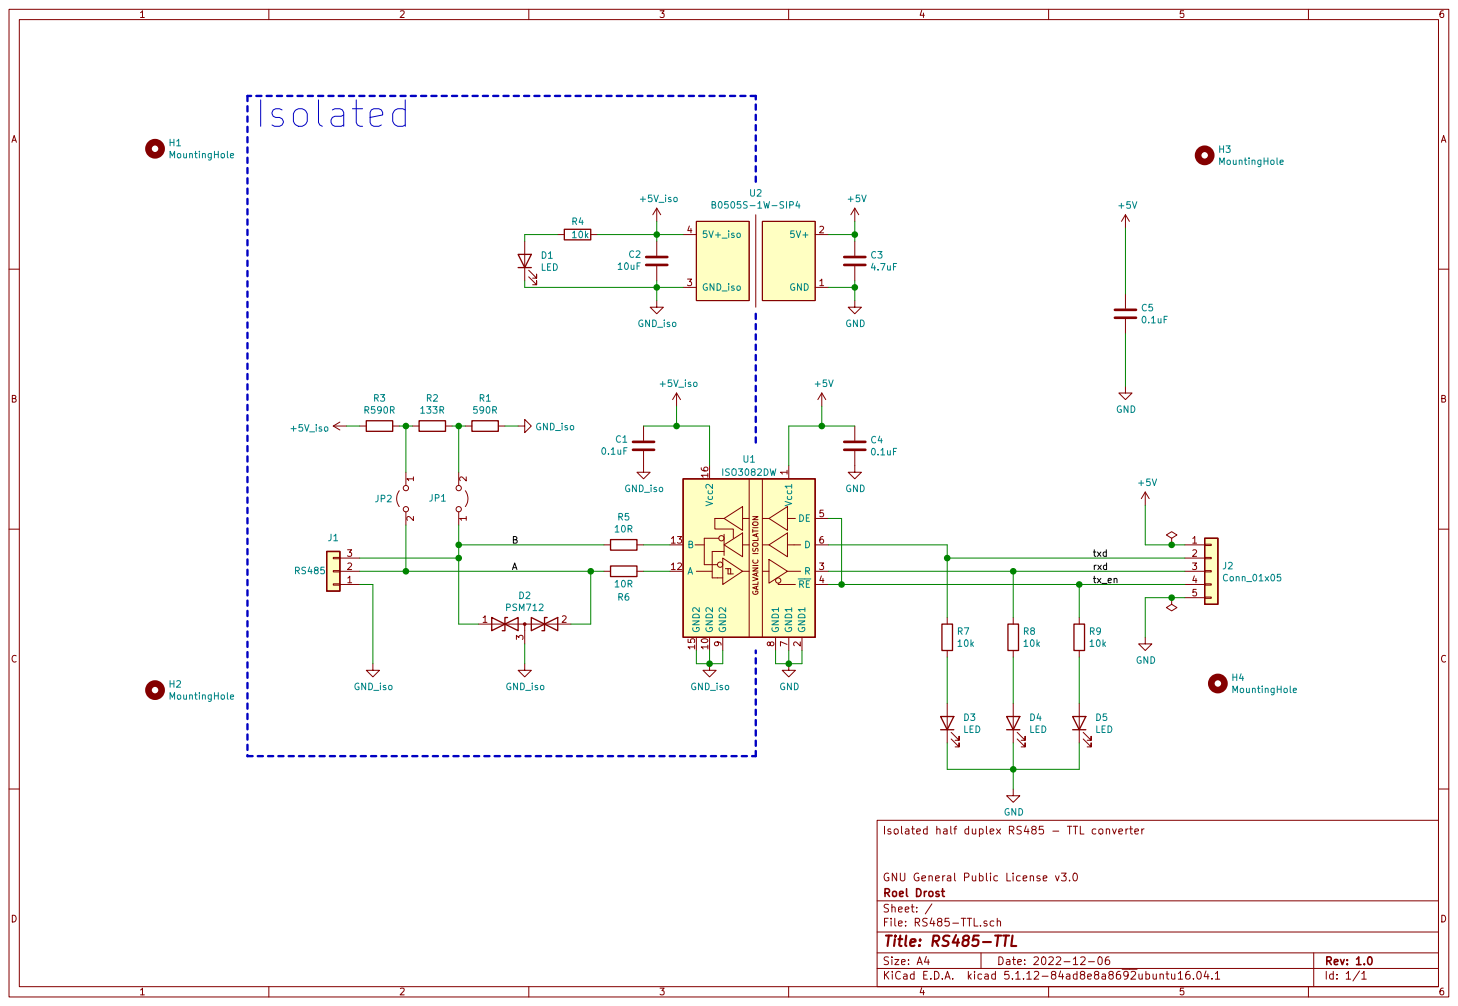
[picture p16: page 1]

File: RS485-TTL.sch Sheet: / Roel Drost GNU General Public License v3.0
