Roel1983/RGBW-Bar/Devices/LedBar/PCB/LedBar.kicad_pcb

## KiCad design Devices/LedBar/PCB/LedBar.kicad_pcb (continued)

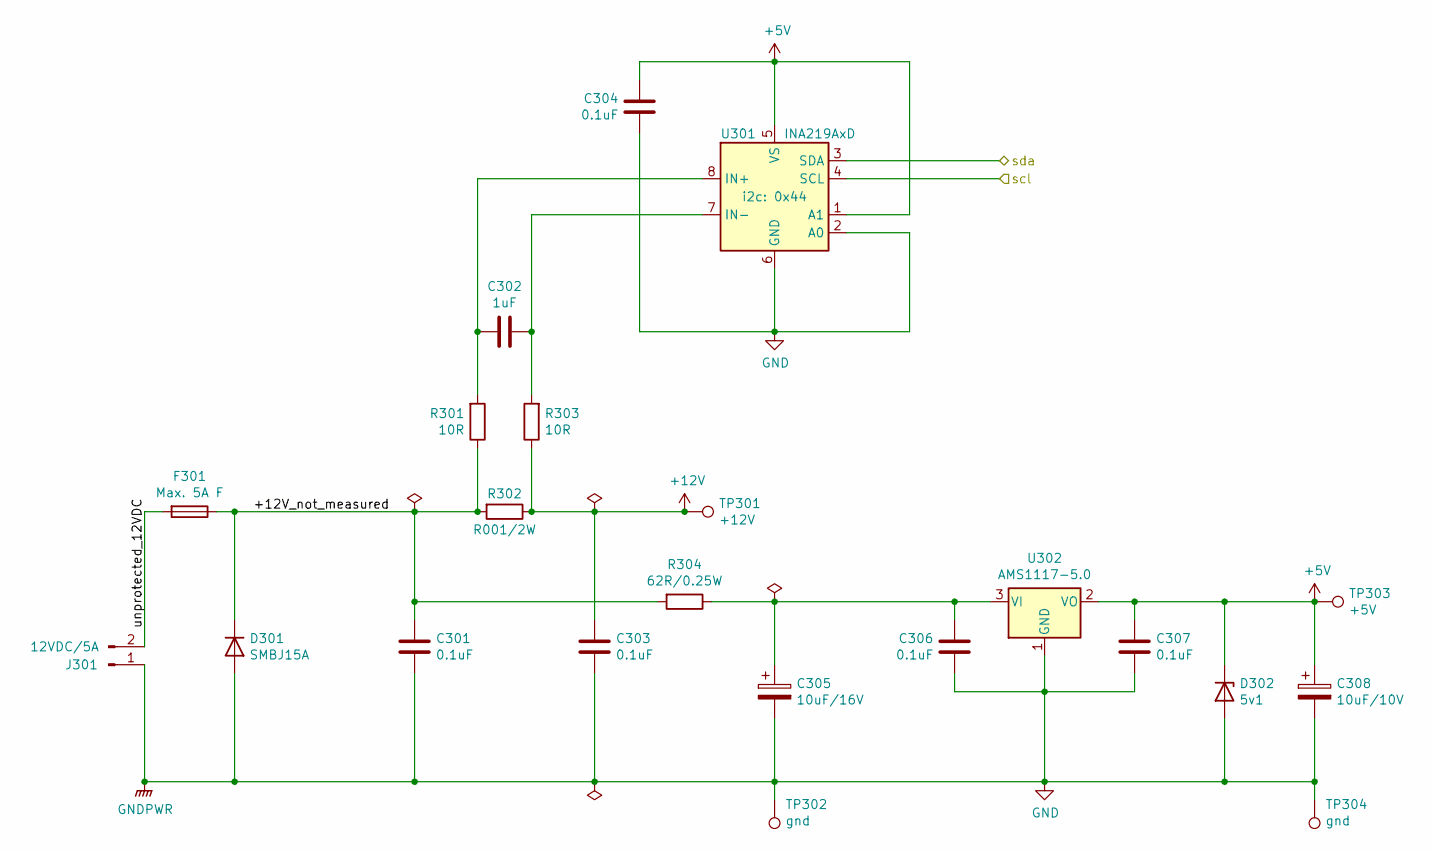
[picture p29: schematic Power.sch, LedBar - MainBoard]

Parts:
C301, C303, C304, C306, C307: 0.1uF; C_0805_2012Metric_Pad1.18x1.45mm_HandSolder
C302: 1uF; C_0805_2012Metric_Pad1.18x1.45mm_HandSolder
C305: 10uF/16V; CP_EIA-6032-28_Kemet-C_Pad2.25x2.35mm_HandSolder
C308: 10uF/10V; CP_EIA-3216-18_Kemet-A_Pad1.58x1.35mm_HandSolder
D301: SMBJ15A; D_SMB_Handsoldering
D302: 5v1; D_1206_3216Metric_Pad1.42x1.75mm_HandSolder
F301: Max. 5A F; Fuseholder_Cylinder-5x20mm_BLX_A_Horizontal
J301: 12VDC/5A; 2EDGRC-5.08-2P
R301, R303: 10R; R_0805_2012Metric_Pad1.20x1.40mm_HandSolder
R302: R001/2W; R_2512_6332Metric_Pad1.40x3.35mm_HandSolder
R304: 62R/0.25W; R_1210_3225Metric_Pad1.30x2.65mm_HandSolder
TP301: +12V; TestPoint_Pad_D1.0mm
TP302, TP304: gnd; TestPoint_Pad_D1.0mm
TP303: +5V; TestPoint_Pad_D1.0mm
U301: INA219AxD; SOIC-8_3.9x4.9mm_P1.27mm
U302: AMS1117-5.0; SOT-223-3_TabPin2

Connections:
+5V: C304.2, C307.1, C308.1, D302.1 (K), TP303.1, U301.1 (A1), U301.5 (VS), U302.2 (VO); also elsewhere on the board
+12V: C303.1, R302.1, R303.1, TP301.1; also elsewhere on the board
/Mainboard/Microcontroller/scl: U301.4 (SCL); also elsewhere on the board
/Mainboard/Microcontroller/sda: U301.3 (SDA); also elsewhere on the board
/Mainboard/Power/+12V_not_measured: C301.1, D301.1 (K), F301.1, R301.1, R302.2, R304.2
/Mainboard/Power/unprotected_12VDC: F301.2, J301.2
GND: C301.2, C303.2, C304.1, C305.2, C306.1, C307.2, C308.2, D301.2 (A), D302.2 (A), J301.1, TP302.1, TP304.1, U301.2 (A0), U301.6 (GND), U302.1 (GND); also elsewhere on the board
unnamed: C302.1, R303.2, U301.7 (IN-)
unnamed: C302.2, R301.2, U301.8 (IN+)
unnamed: C305.1, C306.2, R304.1, U302.3 (VI)

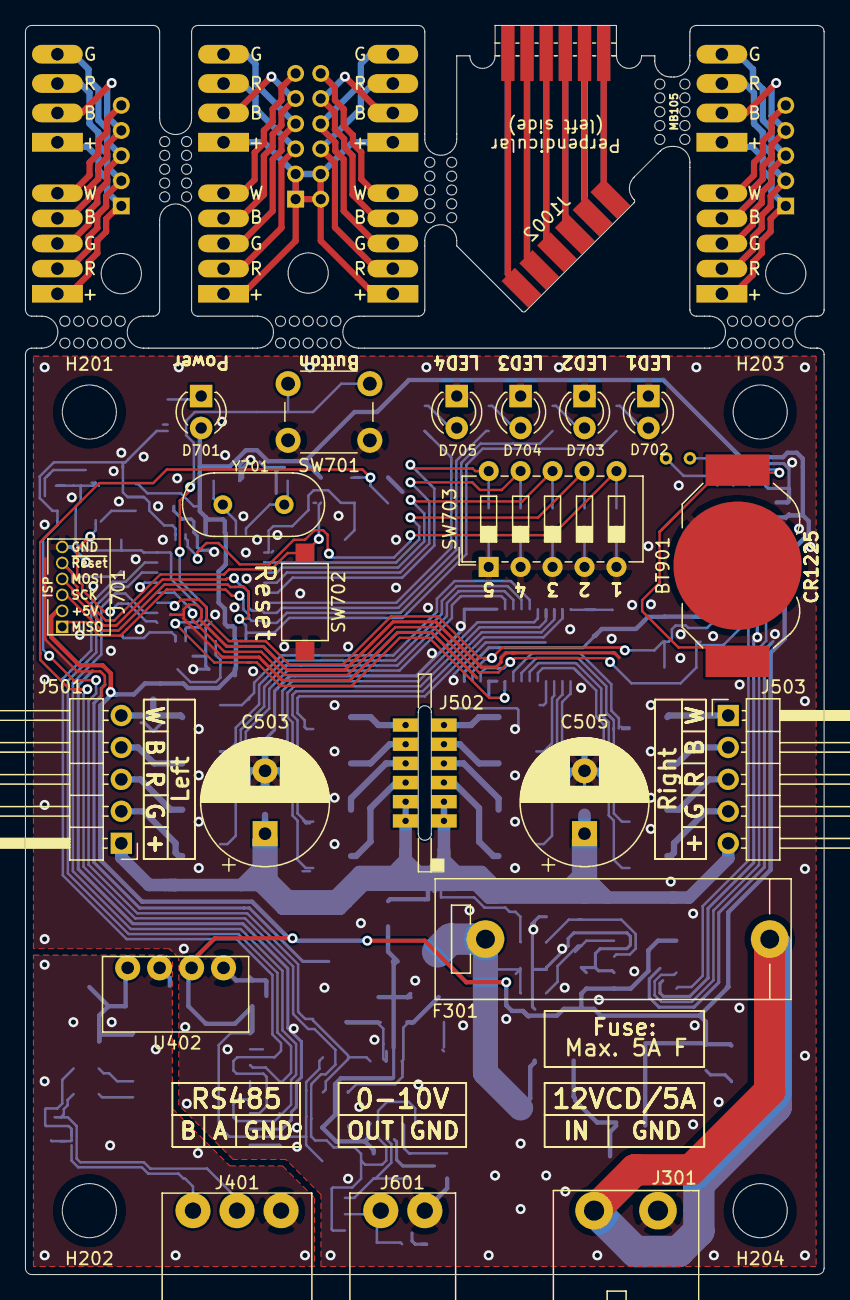
[picture p30: board LedBar.kicad_pcb from above]

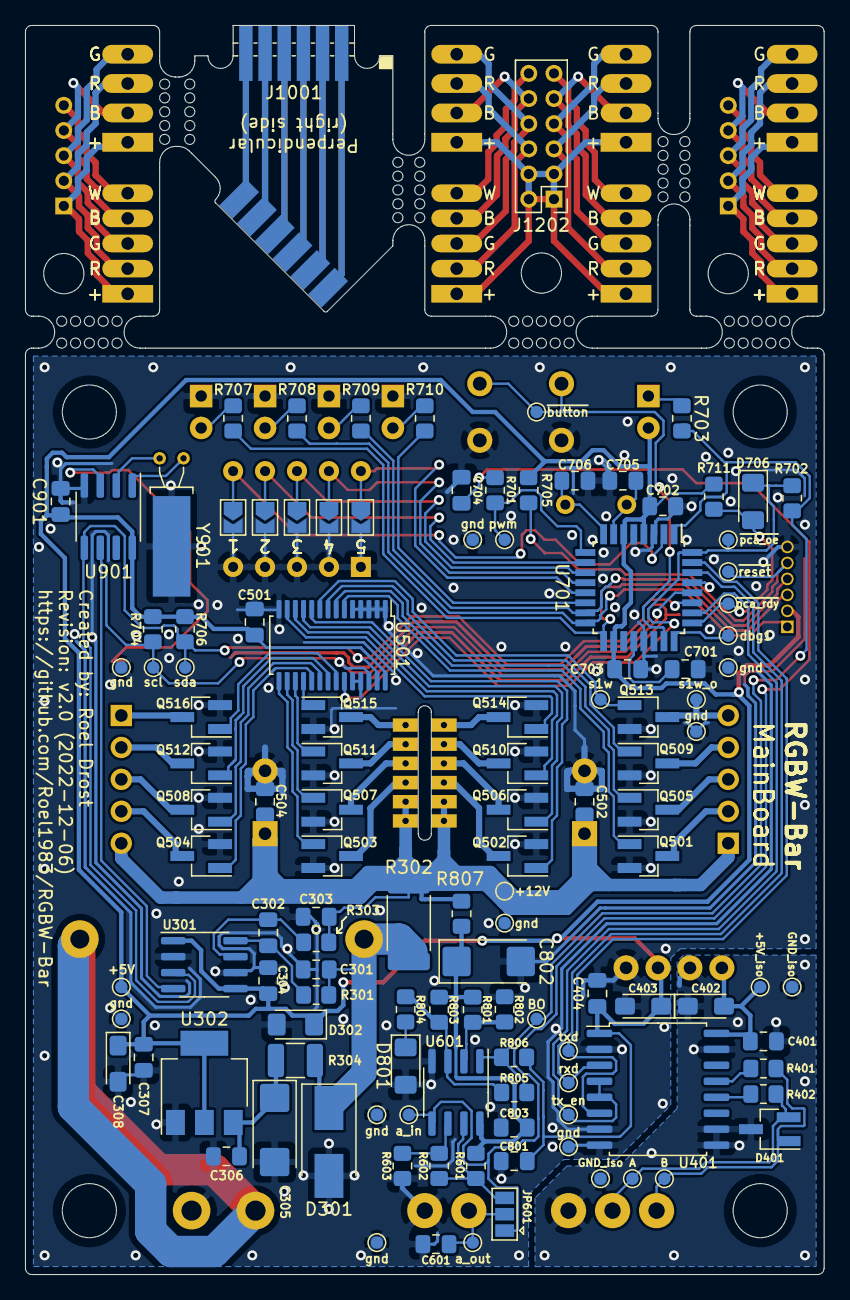
[picture p31: board LedBar.kicad_pcb from below]

Board: 2 copper layers, 63.5 x 99.3 mm, 167 parts (123 on the bottom side), 117 nets.
