Roel1983/RGBW-Bar/Devices/RS485-TTL/PCB/RS485-TTL.kicad_pcb

## KiCad design Devices/RS485-TTL/PCB/RS485-TTL.kicad_pcb (2022-12-06)

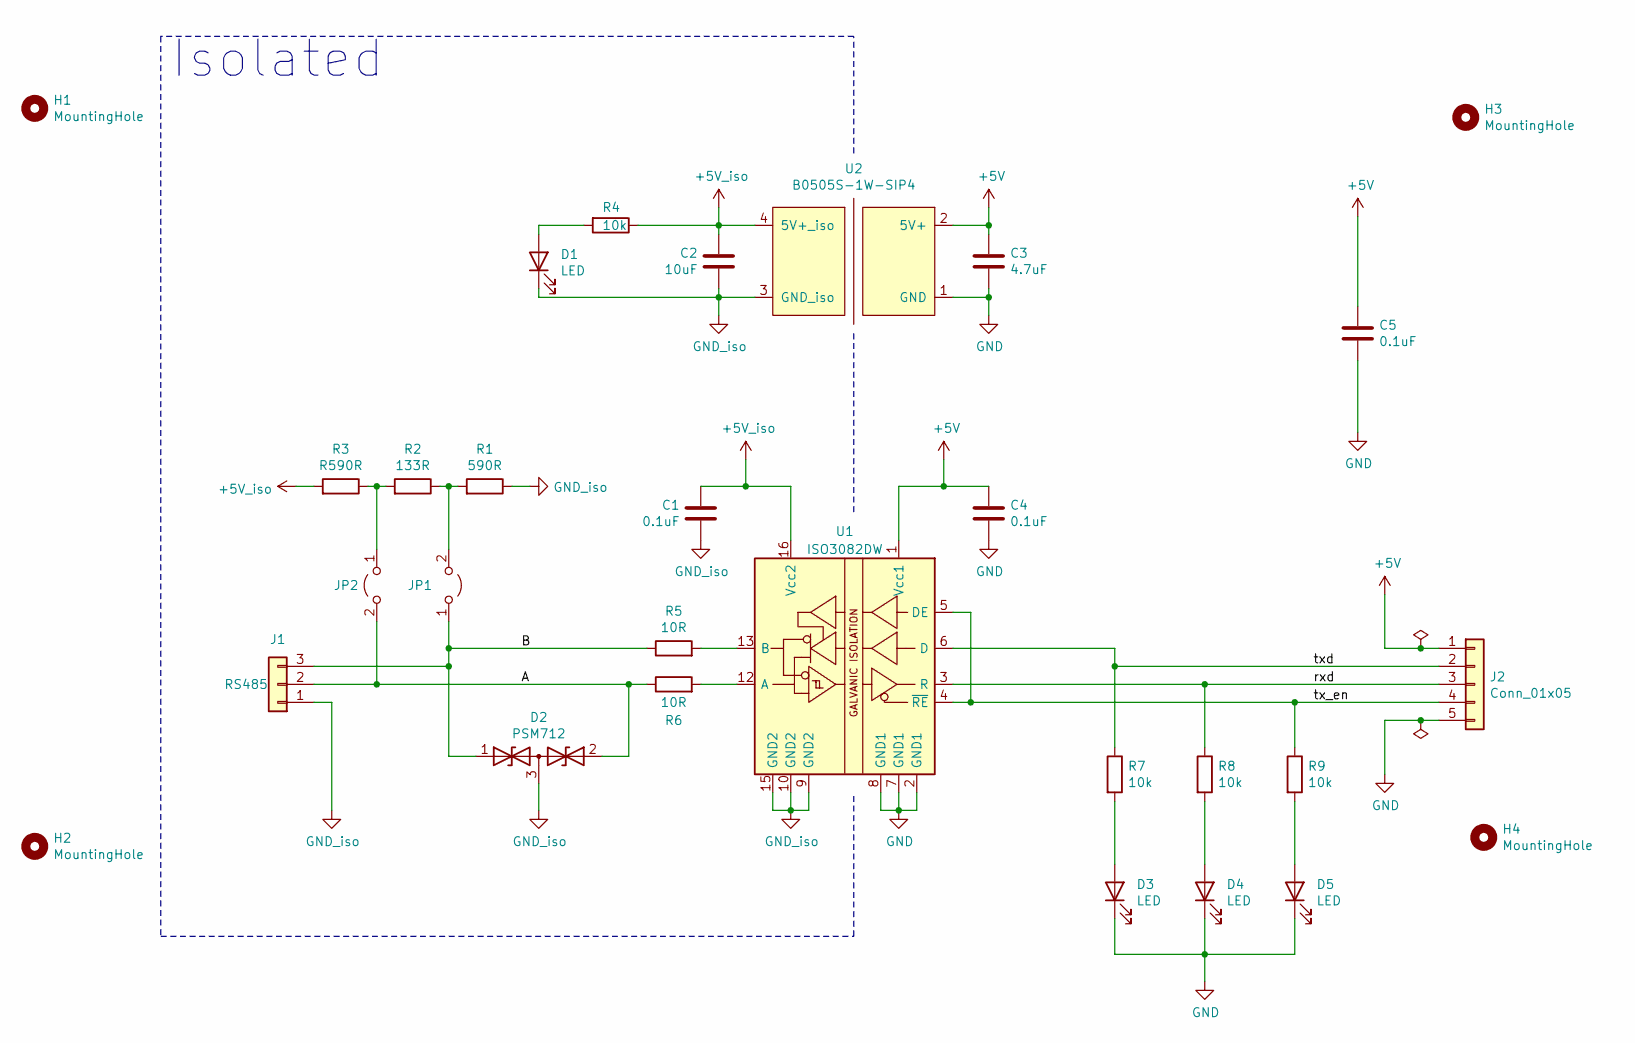
[picture p32: schematic RS485-TTL.sch]

Parts:
C1, C4, C5: 0.1uF; C_0805_2012Metric_Pad1.18x1.45mm_HandSolder
C2: 10uF; CP_EIA-3216-18_Kemet-A_Pad1.58x1.35mm_HandSolder
C3: 4.7uF; CP_EIA-3216-18_Kemet-A_Pad1.58x1.35mm_HandSolder
D1, D3, D4, D5: LED; LED_0805_2012Metric_Pad1.15x1.40mm_HandSolder
D2: PSM712; SOT-23_Handsoldering
H1, H2, H3, H4: MountingHole; MountingHole_3.2mm_M3
J1: RS485; 15EDGRC-3.5-3P
J2: Conn_01x05; PinHeader_1x05_P2.54mm_Vertical
JP1, JP2: Jumper_2_Open; PinSocket_1x02_P2.54mm_Vertical
R1: 590R; R_0805_2012Metric_Pad1.20x1.40mm_HandSolder
R2: 133R; R_0805_2012Metric_Pad1.20x1.40mm_HandSolder
R3: R590R; R_0805_2012Metric_Pad1.20x1.40mm_HandSolder
R4, R7, R8, R9: 10k; R_0805_2012Metric_Pad1.20x1.40mm_HandSolder
R5, R6: 10R; R_0805_2012Metric_Pad1.20x1.40mm_HandSolder
U1: ISO3082DW; SOIC-16W_7.5x10.3mm_P1.27mm
U2: B0505S-1W-SIP4; B0505S-1W

Connections:
+5V: C3.1, C4.1, C5.1, J2.1, U1.1 (Vcc1), U2.2 (5V+)
+5V_iso: C1.2, C2.2, R3.2, R4.1, U1.16 (Vcc2), U2.4 (5V+_iso)
/A: D2.2 (A2), J1.2, JP2.2 (B), R6.1
/B: D2.1 (A1), J1.3, JP1.1 (A), R5.1
/rxd: J2.3, R8.1, U1.3 (R)
/tx_en: J2.4, R9.1, U1.4 (~RE), U1.5 (DE)
/txd: J2.2, R7.1, U1.6 (D)
GND: C3.2, C4.2, C5.2, D3.1 (K), D4.1 (K), D5.1 (K), J2.5, U1.2 (GND1), U1.7 (GND1), U1.8 (GND1), U2.1 (GND)
GND_iso: C1.1, C2.1, D1.1 (K), D2.3 (common), J1.1, R1.1, U1.9 (GND2), U1.10 (GND2), U1.15 (GND2), U2.3 (GND_iso)
unnamed: D1.2 (A), R4.2
unnamed: D3.2 (A), R7.2
unnamed: D4.2 (A), R8.2
unnamed: D5.2 (A), R9.2
unnamed: JP1.2 (B), R1.2, R2.1
unnamed: JP2.1 (A), R2.2, R3.1
unnamed: R5.2, U1.13 (B)
unnamed: R6.2, U1.12 (A)

Notes on the sheet:
Isolated

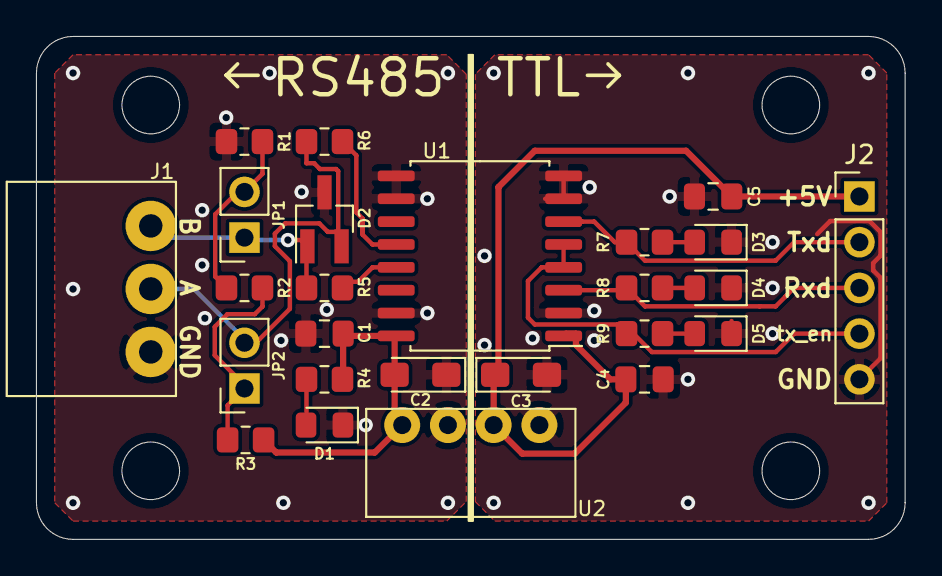
[picture p33: board RS485-TTL.kicad_pcb from above]

Board: 2 copper layers, 48.3 x 27.9 mm, 29 parts (0 on the bottom side), 17 nets.
