Roel1983/RGBW-Bar/Devices/LedBar/Firmware/RGBW-Bar/src/communication/receiver/receiver.cpp

#include <avr/interrupt.h>
#include <avr/io.h>

#include <assert.h>
#ifdef UNITTEST
#include <cstring>
#endif

#include "../../timestamp.hpp"
#include "../../utils.hpp"
#include "../commands.hpp"
#include "../communication.hpp"
#include "../../leds.hpp" // tmp
#include "command.hpp"
#include "receiver_errors.hpp"

using namespace communication;

namespace communication {
namespace receiver {

typedef enum {
	STATE_PREAMBLE,
	STATE_SENDER_UNIQUE_ID,
	STATE_COMMAND_ID,
	STATE_PAYLOAD_LENGTH,
	STATE_BLOCK_NR,
	STATE_CRC,
	STATE_IGNORE,
} State;

struct Isr {
	volatile State     state;
	uint8_t            crc;
	uint8_t            read_byte_count;
	uint8_t           *read_byte_pos;
	uint8_t            preamble_count;
	uint16_t           remaining_payload_length;
	uint8_t            command_id;
	uint8_t            block_nr;
	uint16_t           skip_byte_count;
	uint16_t           skip_byte_count_after_read;
	uint8_t            sender_unique_id;
	const CommandInfo* command_info;
};

PRIVATE Isr      isr;
PRIVATE volatile bool did_ignore_in_comming_data;
PRIVATE volatile timestamp::Timestamp start_receving_timestamp;

PRIVATE constexpr timestamp::Timestamp RECEIVE_TIMEOUT = 250;

PRIVATE INLINE void processIncommingByte     (const uint8_t data_byte);
PRIVATE INLINE bool receiveBlockData         (const uint8_t data_byte);
PRIVATE INLINE void receivePreamble          (const uint8_t data_byte);
PRIVATE INLINE void receiveSenderUniqueId    (const uint8_t data_byte);
PRIVATE INLINE void receiveCommandId         (const uint8_t data_byte);
PRIVATE INLINE void receivePayloadLength     (const uint8_t data_byte);
PRIVATE INLINE void receiveUnknownCommand();
PRIVATE INLINE void receiveBroadcastCommand();
PRIVATE INLINE void receiveAddressableCommand();
PRIVATE INLINE void receiveBlockNr           (const uint8_t data_byte);

PRIVATE INLINE void calculateReceiveBlockData(CommandBase& command, const uint8_t block_count);
PRIVATE INLINE void receiveCrc               (const uint8_t data_byte);

PRIVATE INLINE void notifyCommandReceived(const CommandInfo& command_info);
PRIVATE INLINE void notifySingleBlockCommandReceived(const CommandInfo& command_info);
PRIVATE INLINE void notifyMultiBlockCommandReceived(const CommandInfo& command_info);

PRIVATE void receiveSkipRemainingPayload();
PRIVATE void reset();

#ifdef UNITTEST
void tearDown() {
	memset(&isr, 0, sizeof(isr));
	ReceiverErrorsTearDown();
}
#endif

void setup() {
	UCSR0B |= _BV(RXEN0)
	       |  _BV(RXCIE0);
}

void loop() {
	uint8_t c = 0;
	uint8_t d = 0;
	const uint8_t count = getCommandInfoCount();
	for (uint8_t command_id = 0; command_id < count; command_id++) {
		const receiver::CommandInfo *command_info = getCommandInfo(command_id);
		if (!command_info) {
			continue;
		}
		if (command_info->command.lock == COMMAND_LOCK_WRITE) { // tmp
			c++;
		}
		if (command_info->command.lock == COMMAND_LOCK_READ) { // tmp
			d++;
		}
		if (command_info->command.lock == COMMAND_LOCK_READ) {
			notifyCommandReceived(*command_info);
		}
	}
	leds::set(leds::ORANGE, (c>0)?leds::LED_ON:leds::LED_OFF); // tmp
	
	cli();
	timestamp::Timestamp ts = timestamp::getMsTimestamp();
	if (isr.state != STATE_PREAMBLE && isr.state != STATE_IGNORE
			&& (ts - start_receving_timestamp) > RECEIVE_TIMEOUT) {
		raiseError(ERROR_TIMEOUT);
		reset();
	}
	sei();
	
	const CommandInfo *ci;
	if ((ci = getCommandInfo(0)) && ci->block_size != 2) leds::blink(leds::YELLOW, 1);
}

void dbg(uint8_t v) {
	for(int i = 0; i < v; i++) {
		PORTC ^= _BV(1);
		for (volatile int w = 0; w < 1; w++) asm("nop");
		PORTC ^= _BV(1);
		asm("nop");
		asm("nop");
		asm("nop");
		asm("nop");
	}
} 

ISR(USART_RX_vect) {
	PORTC |= _BV(1); // tmp
	const uint8_t data_byte = UDR0; // Read regardless signal error in order to reset interrupt flag
	const bool has_signal_error = (UCSR0A & ((1 << FE0) | (1 << DOR0) | (1 << UPE0))) != 0;
	if(has_signal_error) {
		if (isr.state != STATE_IGNORE) {
			raiseError(ERROR_SIGNAL);
			reset();
		} else {
			did_ignore_in_comming_data = true;
		}
	} else {
		processIncommingByte(data_byte);
	}
	PORTC &= ~_BV(1); // tmp
}

PRIVATE INLINE void processIncommingByte(const uint8_t data_byte) {
	isr.crc += data_byte;
	
	if (receiveBlockData(data_byte)) {
		dbg(6);
		return;
	}
	
	switch (isr.state) {
	case STATE_PREAMBLE:
		dbg(1);
		receivePreamble(data_byte);
		return;
	case STATE_SENDER_UNIQUE_ID:
		dbg(2);
		receiveSenderUniqueId(data_byte);
		return;
	case STATE_COMMAND_ID:
		dbg(3);
		receiveCommandId(data_byte);
		return;
	case STATE_PAYLOAD_LENGTH:
		dbg(4);
		receivePayloadLength(data_byte);
		return;
	case STATE_BLOCK_NR:
		dbg(5);
		receiveBlockNr(data_byte);
		return;
	case STATE_CRC:
		dbg(7);
		receiveCrc(data_byte);
		return;
	case STATE_IGNORE:
		dbg(8);
		did_ignore_in_comming_data = true;
		return;
	}
}

PRIVATE INLINE bool receiveBlockData(const uint8_t data_byte) {
	if (isr.skip_byte_count) {
		--isr.skip_byte_count;
		return true;
	}
	if (isr.read_byte_count) {
		--isr.read_byte_count;
		*(isr.read_byte_pos++) = data_byte;
		return true;
	}
	if (isr.skip_byte_count_after_read) {
		isr.skip_byte_count = isr.skip_byte_count_after_read - 1;
		isr.skip_byte_count_after_read = 0;
		return true;
	}
	return false;
}

PRIVATE INLINE void receivePreamble(const uint8_t data_byte) {
	if (data_byte != PREAMBLE_BYTE) {
		raiseError(ERROR_PREAMBLE);
		isr.preamble_count = 0;
		return;
	}
	if (++isr.preamble_count >= PREAMBLE_COUNT) {
		isr.crc = 0;
		start_receving_timestamp = timestamp::getMsTimestamp();
		isr.state = STATE_SENDER_UNIQUE_ID;
	}
}

PRIVATE INLINE void receiveSenderUniqueId(const uint8_t data_byte) {
	isr.sender_unique_id = data_byte;
	isr.state = STATE_COMMAND_ID;
}

PRIVATE INLINE void receiveCommandId(const uint8_t data_byte) {
	const uint8_t command_id     = data_byte;
	isr.command_id               = command_id;
	isr.command_info             = getCommandInfo(command_id);
	isr.remaining_payload_length = 0;
	isr.state                    = STATE_PAYLOAD_LENGTH;
}

PRIVATE INLINE void receivePayloadLength(const uint8_t data_byte) {
	if (data_byte & EXTENDED_PAYLOAD_LENGHT_MASK) {
		isr.remaining_payload_length = (data_byte & ~EXTENDED_PAYLOAD_LENGHT_MASK) << 8;
		return;
	} else {
		isr.remaining_payload_length |= data_byte;
	}
	
	if (!isr.command_info) {
		receiveUnknownCommand();
	} else if (isr.command_info->type == COMMAND_TYPE_BROADCAST) {		
		receiveBroadcastCommand();
	} else {
		receiveAddressableCommand();
	}
}

PRIVATE INLINE void receiveUnknownCommand() {
	receiveSkipRemainingPayload();
}

PRIVATE INLINE void receiveBroadcastCommand() {
	CommandBase& command(isr.command_info->command);
	
	if (isr.command_info->block_size != isr.remaining_payload_length) {
		raiseError(ERROR_INVALID_LENGTH_1);
		reset();
		return;
	}
	if (command.lock != COMMAND_LOCK_NONE) {
		receiveSkipRemainingPayload();
		raiseError(ERROR_BUSY);
		return;
	}
	command.lock = COMMAND_LOCK_WRITE;
	
	isr.read_byte_count = isr.remaining_payload_length;
	isr.read_byte_pos   = command.buffer;
	isr.state           = STATE_CRC;
}

PRIVATE INLINE void receiveAddressableCommand() {
	isr.remaining_payload_length -= 1; 
	
	if ((isr.remaining_payload_length % isr.command_info->block_size) != 0) {
		
		//~ delay_us(1);
		//~ dbg(isr.remaining_payload_length)
		//~ delay_us(1);
		//~ dbg(isr.command_info->block_size);
		//~ delay_us(1);
		
		raiseError(ERROR_INVALID_LENGTH_2);
		reset();
		return;
	}
	isr.state = STATE_BLOCK_NR;
}

PRIVATE INLINE void receiveBlockNr(const uint8_t data_byte) {
	CommandBase& command(isr.command_info->command);
	
	isr.block_nr = data_byte;
	
	if (command.lock != COMMAND_LOCK_NONE) {
		receiveSkipRemainingPayload();
		raiseError(ERROR_BUSY);
		return;
	}
	
	const uint8_t block_count = isr.remaining_payload_length / isr.command_info->block_size;
	calculateReceiveBlockData(command, block_count);
	
	if (isr.read_byte_count) {
		command.lock = COMMAND_LOCK_WRITE;
	}
	isr.state = STATE_CRC;
}

PRIVATE INLINE void calculateReceiveBlockData(CommandBase& command, const uint8_t block_count) {
	const CommandInfo& command_info(*isr.command_info);
	const CommandType command_type = command_info.type;
	
	const uint8_t my_block_nr    = commandTypeGetBlockNr   (command_type);
	const uint8_t my_block_count = commandTypeGetBlockCount(command_type);
	const uint8_t block_size     = command_info.block_size;
	
	uint8_t skip_block_count_before_read;
	uint8_t read_block_count;
	uint8_t skip_block_count_after_read;
	
	if (isr.block_nr <= my_block_nr) {
		skip_block_count_before_read = my_block_nr - isr.block_nr;
		if (skip_block_count_before_read >= block_count) {
			skip_block_count_before_read = block_count;
			isr.read_byte_count            = 0;
			isr.skip_byte_count_after_read = 0;
		} else {
			read_block_count = block_count - skip_block_count_before_read;
			if (read_block_count > my_block_count) {
				skip_block_count_after_read = read_block_count - my_block_count;
				isr.skip_byte_count_after_read = skip_block_count_after_read * block_size;
				read_block_count = my_block_count;
			} else {
				isr.skip_byte_count_after_read = 0;
			}
			isr.read_byte_count = read_block_count * block_size;
			isr.read_byte_pos   = command_info.command.buffer;
			command.processed_block_bits = (1 << read_block_count) - 1;
		}
		isr.skip_byte_count = skip_block_count_before_read * block_size;
	} else {
		const uint8_t my_end_block_nr = my_block_nr + my_block_count;
		read_block_count = (isr.block_nr < my_end_block_nr) ? my_end_block_nr - isr.block_nr : 0;
		
		if (read_block_count >= block_count) {
			read_block_count = block_count;
			isr.skip_byte_count_after_read = 0;
			isr.skip_byte_count = 0;
		} else {
			skip_block_count_after_read = block_count - read_block_count;
			isr.skip_byte_count_after_read = skip_block_count_after_read * block_size;
			isr.skip_byte_count = 0;
		}
		uint8_t read_block_offset = (isr.block_nr - my_block_nr);
		command.processed_block_bits = ((1 << read_block_count) - 1) << read_block_offset;
		
		isr.read_byte_count = read_block_count * block_size;
		isr.read_byte_pos   = isr.command_info->command.buffer + read_block_offset * block_size;
	}
}

PRIVATE INLINE void receiveCrc(const uint8_t data_byte) {
	const CommandInfo& command_info(*isr.command_info);
	CommandBase&       command(command_info.command);
	
	if (isr.crc != 0) {
		if (command.lock == COMMAND_LOCK_WRITE) {
			command.lock = COMMAND_LOCK_NONE;
		}
		raiseError(ERROR_CRC);
		isr.preamble_count = 0;
		isr.state          = STATE_PREAMBLE;
		return;
	}
	
	if (command.lock == COMMAND_LOCK_WRITE) {
		command.lock = COMMAND_LOCK_READ;
		
		if (command_info.is_allow_notify_from_isr) {
			notifyCommandReceived(command_info);
		}
	}
	isr.preamble_count = 0;
	isr.state          = STATE_PREAMBLE;
}

PRIVATE INLINE void notifyCommandReceived(const CommandInfo& command_info) {
	if (commandTypeGetBlockCount(command_info.type) == 1) {
		notifySingleBlockCommandReceived(command_info);
	} else {
		notifyMultiBlockCommandReceived(command_info);
	}
}

PRIVATE INLINE void notifySingleBlockCommandReceived(const CommandInfo& command_info) {
	CommandBase& command(command_info.command);
	if (command_info.onReceived(0, command.buffer)) {
		command.lock = COMMAND_LOCK_NONE;
	}
}

PRIVATE INLINE void notifyMultiBlockCommandReceived(const CommandInfo& command_info) {
	CommandBase& command(command_info.command);
	
	uint8_t relative_block_nr = 0;
	uint8_t processed_block_bits = command.processed_block_bits;
	uint8_t processed_block_bit = 0b1;
	while(processed_block_bits) {
		if (processed_block_bits & processed_block_bit && 
				command_info.onReceived(
					relative_block_nr,
					&command.buffer[relative_block_nr * command_info.block_size]))
		{
			command.processed_block_bits &= ~processed_block_bit;
		}
		processed_block_bits &= ~processed_block_bit;
		relative_block_nr++;
		processed_block_bit <<= 1;
	}
	if (!command.processed_block_bits) {
		command.lock = COMMAND_LOCK_NONE;
	}
}

PRIVATE void receiveSkipRemainingPayload() {
	isr.skip_byte_count            = isr.remaining_payload_length;
	isr.read_byte_count            = 0;
	isr.skip_byte_count_after_read = 0;
	isr.state                      = STATE_CRC;
}

void ignore(bool is_ignore) {
	cli();
	if (is_ignore) {
		isr.state = STATE_IGNORE;
		did_ignore_in_comming_data = false;
	} else {
		reset();
	}
	sei();
}

bool didIgnoreIncomingData() {
	const bool res = did_ignore_in_comming_data;
	did_ignore_in_comming_data = false;
	return res;
}

PRIVATE void reset() {
	if (isr.state >= STATE_PAYLOAD_LENGTH && isr.command_info 
			&& isr.command_info->command.lock == COMMAND_LOCK_WRITE)
	{
		isr.command_info->command.lock = COMMAND_LOCK_NONE;
	}	
	isr.state = STATE_PREAMBLE;
	isr.preamble_count = 0;
	isr.read_byte_count = 0;
	isr.skip_byte_count = 0;
	isr.skip_byte_count_after_read = 0;
}

}} // End of namespace ::communication::receiver
