Roel1983/RGBW-Bar/Devices/LedBar/Firmware/RGBW-Bar/src/communication/receiver/receiver_errors.cpp

#ifdef UNITTEST
#include <cstring>
#endif

#include "../../leds.hpp"
#include "receiver_errors.hpp"

namespace communication {
namespace receiver {

volatile uint8_t error_counts[error_count] = { 0 };
volatile bool    must_reset = false;

#ifdef UNITTEST
void ReceiverErrorsTearDown() {
	memset((void*)&error_counts, 0, sizeof(error_counts));
	must_reset = false;
}
#endif

void raiseError(const Error error) {
	static int error_count = 0;
	error_count++;
	leds::blink(leds::RED, error_count);
	//leds::blink(leds::RED, error);
	//~ if(error_counts[error] != 0xff) {
		//~ error_counts[error]++;
	//~ }
}

}}
