Roel1983/RGBW-Bar/Devices/LedBar/Firmware/RGBW-Bar/src/strobe.hpp

#ifndef _STROBE_HPP_
#define _STROBE_HPP_

#include "color.hpp"
#include "timestamp.hpp"
#include "types.hpp"

#include "communication/communication.hpp"

namespace strobe {

static constexpr uint8_t COUNT_INFINITE = 0xFF;

void         trigger        (timestamp::Timestamp on, timestamp::Timestamp off, uint8_t count);
Factor       getStripFactor (int index);
const Color& getStripColor  (int index);
void         setStripColor  (int index, const Color& color);
void         setStripWeight (int index, Factor weight);

extern communication::receiver::CommandInfo trigger_command_info;
extern communication::receiver::CommandInfo strip_color_command_info;
extern communication::receiver::CommandInfo strip_weight_command_info;

} // End of: namespace strobe

#endif // _STROBE_HPP_
