Roel1983/RGBW-Bar/Devices/LedBar/Firmware/RGBW-Bar/src/button.hpp

#ifndef _BUTTON_HPP_
#define _BUTTON_HPP_

namespace button {
	
void setup();
void loop();
bool isPressedShort();
bool isPressedLong();
bool isPressedVeryLong();

} // End of: namespace button

#endif
