Roel1983/RGBW-Bar/Devices/LedBar/Firmware/RGBW-Bar/src/bootloader.cpp

#include <util/delay.h> 

#include "bootloader.hpp"

#ifndef BOOT_LOADER_ADDRESS
#define BOOT_LOADER_ADDRESS 0x7800
#endif

namespace bootloader {

struct BootloaderCommand;

static bool onBootloaderCommand(const BootloaderCommand& command);

void execute() {
  typedef void (*BootLoaderMeth)(void);
  ((BootLoaderMeth)BOOT_LOADER_ADDRESS)();
}

struct BootloaderCommand {
	uint8_t unique_id;
	uint8_t seconds_timeout;
};

communication::receiver::Command<communication::COMMAND_TYPE_BROADCAST, BootloaderCommand> bootloader_command;

communication::receiver::CommandInfo bootloader_command_info(
	bootloader_command,
	onBootloaderCommand);

static bool onBootloaderCommand(const BootloaderCommand& command) {
	if (commandTypeGetBlockNr(communication::COMMAND_TYPE_UNIQUE_ID) == command.unique_id) {
		_delay_ms(3000);
		bootloader::execute();
	} else {
		communication::ignoreBootloader(command.seconds_timeout * 1000);
	}
	return true;
}

} // End of: namespace bootloader
