Roel1983/RGBW-Bar/Devices/LedBar/Firmware/RGBW-Bar/src/bootloader.hpp

#ifndef _BOOTLOADER_HPP_
#define _BOOTLOADER_HPP_

#include "communication/communication.hpp"

namespace bootloader {

void execute();

extern communication::receiver::CommandInfo bootloader_command_info;

} // End of: namespace bootloader

#endif
