Roel1983/RGBW-Bar/Devices/LedBar/Firmware/RGBW-Bar/src/utils.hpp

#ifndef _UTILS_HPP_
#define _UTILS_HPP_

#include <stdint.h>

#ifdef UNITEST
#define PRIVATE
#define INLINE
#else
#define PRIVATE static
#define INLINE  inline
#endif

template<typename T, uint16_t N>
constexpr uint16_t GetArrLength(T(&)[N]) { return N; }

#endif // _UTILS_HPP_
