Roel1983/RGBW-Bar/(commit log)

2022-06-25 Many small fixes
    [CenterBoard.sch, LedBar.kicad_pcb, LeftBoard.sch, Mainboard.sch, Pca.sch, Power.sch, RightBoard.sch, Rtc.sch]
2022-06-25 Renamed libraries
    [0-10V.sch, Brown-out.sch, CenterBoard.sch, LedBar.kicad_pcb, LedBar.sch, LeftBoard.sch, Mainboard.sch, Microcontroller.sch]
2022-06-26 Added more vias
    [LedBar.kicad_pcb]
2022-06-26 Cosmetic changes to shematics
    [0-10V.sch, Brown-out.sch, CenterBoard.sch, LedBar.kicad_pcb, LedBar.sch, LeftBoard.sch, Mainboard.sch, Microcontroller.sch]
2022-06-26 Fixed microcontroller type
    [LedBar.kicad_pcb, Microcontroller.sch]
2022-06-26 Released LedBar PCB v1.0
    [0-10V.sch, Brown-out.sch, CenterBoard.sch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]
2022-10-30 [Issue #001] Fix color channel order of strips
    [CenterBoard.sch, LedBar.kicad_pcb, LeftBoard.sch, Pca.sch, Perpendicular.sch, RightBoard.sch]
2022-10-30 [Issue #003] Fix clearance of iso_GND testpin TP405
    [LedBar.kicad_pcb]
2022-10-31 [Issue #009] Fix silk layer of H203
    [LedBar.kicad_pcb]
2022-10-31 [Issue #010] Add clearance around screw holes
    [LedBar.kicad_pcb]
2022-10-31 [Issue #005] Inverse brown-out LED
    [LedBar.kicad_pcb, Microcontroller.sch]
2022-10-31 [Issue #013] Disable LED when at power up until initialization is complete
    [LedBar.kicad_pcb, Microcontroller.sch]
2022-10-31 [Issue #016] Remove load resistor on +5V_iso
    [LedBar.kicad_pcb, RS485.sch]
2022-10-31 [Issue #004] Replace power connector for bigger connector
    [LedBar.kicad_pcb, Power.sch]
2022-11-01 [Issue #008] Fix 5V power suppy so it doesn't fail dangerously
    [LedBar.kicad_pcb, Power.sch]
2022-11-02 [Issue #006] Fix shape of perpendicular board so it corresponds with width of J1002
    [LedBar.kicad_pcb]
2022-11-13 [Issue #011] PCB: Make 'Left' and 'Right' board identical
    [LedBar.kicad_pcb, LeftBoard.sch, RightBoard.sch]
2022-11-14 [Issue #018] PCB: Devide PCB in different boards
    [0-10V.sch, Brown-out.sch, CenterBoard.sch, LedBar.kicad_pcb, LedBar.sch, LeftBoard.sch, Mainboard.kicad_pcb, Mainboard.sch]
2022-11-17 [Issue #019] PCB: Make an extra PCB with an Isolated RS485 only
    [RS485-TTL.kicad_pcb, RS485-TTL.sch]
2022-11-17 [Issue #020] PCB: Serie resistors in RS485 bus must be 10R instead of 120R
    [LedBar.kicad_pcb, Mainboard.kicad_pcb, RS485.sch]
2022-11-17 [Issue #023] PCB: Fix copper layer unprotected_12VDC
    [LedBar.kicad_pcb, Mainboard.kicad_pcb]
2022-11-17 [Issue #021] PCB: Improve mechanical layer
    [LedBar.kicad_pcb, Mainboard.kicad_pcb, Subboards.kicad_pcb]
2022-11-17 Fixed double 'unprotected_12VDC' track
    [LedBar.kicad_pcb, Mainboard.kicad_pcb]
2022-11-30 [Issue #024] PCB: Optional PWM instead of 0-10v
    [0-10V.sch, LedBar.kicad_pcb, Mainboard.kicad_pcb, RightBoard.sch]
2022-12-05 Synchronized Mainboard pcbs
    [LedBar.kicad_pcb]
2022-12-06 'Renamed Devices/LedBar/PCB/Releases/v1.0' to 'Devices/LedBar/PCB/Release'
    [LedBar-B_Cu.gbl, LedBar-B_Mask.gbs, LedBar-B_Paste.gbp, LedBar-B_SilkS.gbo, LedBar-Edge_Cuts.gm1, LedBar-F_Cu.gtl, LedBar-F_Mask.gts, LedBar-F_Paste.gtp]
2022-12-06 Releasing RGBW-LEDBar v2.0
    [0-10V.sch, Brown-out.sch, CenterBoard.sch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]
2022-12-06 Releasing RS485-TTL v1.0
    [RS485-TTL-B_Cu.gbl, RS485-TTL-B_Mask.gbs, RS485-TTL-B_Paste.gbp, RS485-TTL-B_SilkS.gbo, RS485-TTL-Edge_Cuts.gm1, RS485-TTL-F_Cu.gtl, RS485-TTL-F_Mask.gts, RS485-TTL-F_Paste.gtp]
2022-12-07 Updated Devices/LedBar/PCB/Release-instructions.md
2023-04-07 Stript Bootloader added continues mode and status leds
2023-04-13 Added AnalogOut and PowerMonitor
2023-04-13 Addded I2C manager
2023-04-23 Added kicad_pcb_to_scad.py
    [Mainboard.kicad_pcb]
2023-04-27 Initial commit of LedBar 3D case design
    [Bottom.scad, Box.scad, LinearExtrude.scad, Optional.scad, Shapes.scad, Top.scad, Units.scad]
2023-04-27 Added CaseBaseShape.scad
    [Bottom.scad, Bounds.scad, CaseBaseShape.scad]
2023-04-28 Working on LedBar 3D board
    [Mainboard.scad]
2023-04-30 Adding Mainboard
    [Bounds.scad, Box.scad, Footprint.scad, KicadPcbComponent.scad, LinearExtrude.scad, Mainboard.scad, Optional.scad, PlaceFootprints.scad]
2023-05-01 Refactored Footprints Scad files
    [15EDGRC_3_5.scad, 2EDGRC_5_08_2P.scad, B0505S_1W.scad, Battery.scad, BatteryHolder_LINX_BAT_HLD_012_SMT.scad, Button_Switch_SMD.scad, Button_Switch_THT.scad, CP_Radial.scad]
2023-05-01 Fix broken paths
    [Bottom.scad, CaseBaseShape.scad, Top.scad]
2023-05-04 Working on LEDs and Button for the Case
    [Bottom.scad, Button_Switch_THT.scad, LED_D3_0mm.scad, LED_THT.scad, LedBar.kicad_pcb, Mainboard.kicad_pcb, Microcontroller.sch, SW_PUSH_6mm.scad]
2023-05-04 Working on screwholes in case
    [Bottom.scad, MountingHole_4_3mm_M4.scad, ScrewHoles.scad, Top.scad]
2023-05-04 ScrewHoles in Case
    [Bottom.scad, Hex.scad, KicadPcbComponent.scad, ScrewHoles.scad, Top.scad]
2023-05-05 Added support for Perpendicular connector
    [Bottom.scad, Bounds.scad, Perpendicular_pcb_1mm_female_2x6.scad, ScrewHoles.scad]
2023-05-06 Footprint of pinheader
    [Bottom.scad, Mainboard.scad, PinHeader_1x_P2_54mm_Horizontal.scad, Top.scad]
2023-05-06 Added support of for footprint
    [Perpendicular_pcb_1mm_female_2x6.scad, PinHeader_1x_P2_54mm_Horizontal.scad, PlaceFootprints.scad, SW_PUSH_6mm.scad]
2023-05-06 Fixed convecity for button support
    [SW_PUSH_6mm.scad]
2023-05-11 Added connector support to bottom case
    [15EDGRC_3_5.scad, 2EDGRC_5_08_2P.scad, Bottom.scad, Connectors.scad]
2023-05-11 Add SMD resistor footprints
    [Footprint.scad, R_0805_2012Metric_Pad1_20x1_40mm_HandSolder.scad, R_1210_3225Metric_Pad1_30x2_65mm_HandSolder.scad, R_2512_6332Metric_Pad1_40x3_35mm_HandSolder.scad, R_HandSolder.scad, Resistor_SMD.scad]
2023-05-23 Added some color
    [B0505S_1W.scad, BatteryHolder_LINX_BAT_HLD_012_SMT.scad, CP_Radial.scad, Crystal_C38_LF_Horizontal_1EP_style1.scad, Crystal_HC49_U_Vertical.scad, LED_D3_0mm.scad, Mainboard.scad, PinHeader_1x_P2_54mm_Horizontal.scad]
2023-05-25 Added case
    [Bottom.scad, Case.scad, Top.scad]
2023-05-25 Case cutout for connectors
    [15EDGRC_3_5.scad, 2EDGRC_5_08_2P.scad, Button_Switch_THT.scad, CaseBaseShape.scad, LED_THT.scad, Top.scad]
2023-06-06 Added PerpendicularBoard
    [Case.scad, CaseBoards.scad, Connector_PinHeader_2_00mm.scad, Footprint.scad, KicadPcbComponent.scad, PerpendicularBoard.scad, PinHeader_2x06_P200mm_PCB_edge.scad, PinHeader_2x6_P2_00mm_Horizontal.scad]
2023-06-06 Refactored Case Top and Bottom
    [Bottom.scad, Top.scad]
2023-06-08 Added guides to case
    [Bottom.scad, Guides.scad, Top.scad]
2023-06-08 Added git revision number to case
    [Bottom.scad, Git.scad, TextFunctions.scad, Top.scad]
2023-06-08 remove material for battery holder
    [MountingHole_4_3mm_M4_modified1.scad]
2023-06-10 Several improvements of case bottom
    [2EDGRC_5_08_2P.scad, Bottom.scad, Guides.scad, LedBar.kicad_pcb, Mainboard.kicad_pcb, Perpendicular_pcb_1mm_female_2x6.scad, PinHeader_1x_P2_54mm_Horizontal.scad, SW_PUSH_6mm.scad]
2023-06-10 Added mounting feet to case
    [Bottom.scad, MountingFeet.scad]
2023-06-10 Fixed wall thickness of SW_PUSH_6mm support
    [SW_PUSH_6mm.scad]
2023-06-10 Fixed scewhole overlapping with guides
    [Bottom.scad, Top.scad]
2023-06-12 Fixed smd components colliding with case-bottom
    [15EDGRC_3_5.scad, Bottom.scad, D_SMB_Handsoldering.scad, Diode_SMD.scad, Footprint.scad, Guides.scad, Jumper.scad, Perpendicular_pcb_1mm_female_2x6.scad]
2023-06-12 Perpendicular board as component of mainboard
    [CaseBoards.scad, PerpendicularBoard.scad, Perpendicular_pcb_1mm_female_2x6.scad, PinHeader_2x06_P200mm_PCB_edge.scad, PinHeader_2x6_P2_00mm_Horizontal.scad]
2023-06-12 Added bridge to case
    [Bridge.scad, Case.scad, PinHeader_2x06_P200mm_PCB_edge.scad, PinHeader_2x6_P2_00mm_Horizontal.scad, Top.scad]
2023-06-12 Added text to case
    [CaseBaseShape.scad, Top.scad]
2023-06-13 Fixed height of 15EDGRC 3.5mm connector
    [15EDGRC_3_5.scad]
2023-06-13 Added texts and symbols to case
    [Bottom.scad, PinHeader_1x_P2_54mm_Horizontal.scad, Top.scad]
2023-06-13 Increased wall pcb back clearance and added Capacitor_Tantalum_SMD
    [Bottom.scad, CP_EIA_6032_28_Kemet_C_Pad2_25x2_35mm_HandSolder.scad, Capacitor_Tantalum_SMD.scad, Footprint.scad]
2023-06-15 Increased tolerance_z of 2EDGRC_5_08_2P
    [2EDGRC_5_08_2P.scad]
2023-06-15 Hidden screws at the bottom of case
    [ScrewHoles.scad, Top.scad]
2023-06-19 Adding LedProfile
    [Case.scad, CenterBoard.scad, LedBar.scad, LedProfile.scad, Profile.scad, ScrewHoles.scad]
2023-06-19 Working on CenterBoard.scad
    [CenterBoard.scad, Color_wire_solder_pads.scad, Connector_PinHeader_2_00mm.scad, MountingHole_3_2mm_Wall_0_8mm.scad, PinHeader_2x6_P2_00mm_Vertical.scad, RGBW-Bar.scad, RGBW_wire_solder_pads.scad]
2023-06-19 Added hole and nut-slot for CenterBoard
    [MountingHole_3_2mm_Wall_0_8mm.scad, Top.scad]
2023-06-19 Add holes to Profile
    [MountingHole_3_2mm_Wall_0_8mm.scad, PinHeader_2x6_P2_00mm_Vertical.scad, Profile.scad, Top.scad]
2023-06-22 Refactored Top.scad to smaller files
    [CenterBoard.scad, GitRevision.scad, Relief.scad, Top.scad]
2023-06-22 Added extra screws for profile
    [Bridge.scad, CenterBoard.scad, MountingHole_3_2mm_Wall_0_8mm.scad, ProfileScrewHoles.scad, Relief.scad, ScrewHoles.scad, Top.scad]
2023-06-29 Hide buttom-top nuts between print layers
    [ScrewHoles.scad]
2023-06-29 Improved screw holes in case for profile
    [ProfileScrewHoles.scad]
2023-07-13 Added Roof support
    [RoofSupport.scad, Top.scad]
2023-07-20 Add more tolerance around button
    [LED_D3_0mm.scad]
2023-07-31 Add more z tolerance to back connectors #28
    [15EDGRC_3_5.scad, 2EDGRC_5_08_2P.scad, CaseBaseShape.scad, Top.scad]
2023-07-31 Side connector too tight #31
    [PinHeader_1x_P2_54mm_Horizontal.scad]
2023-07-31 Inner rim to hole for J1005 #30
    [PinHeader_2x6_P2_00mm_Horizontal.scad]
2023-07-31 Bevel around button hole #32
    [SW_PUSH_6mm.scad]
2023-07-31 Updated LedBar.png
2023-07-31 Text spacing #29
    [Relief.scad]
2023-12-28 Refactored Single ScrewFoot to own file
    [MountingFeet.scad, ScrewFoot.scad]
2023-12-28 Fixed indentation
    [Bottom.scad]
2023-12-28 Working at MiddleSupports
    [LedBar.scad, MiddleSupportLeft.scad, MiddleSupportRight.scad, Support.scad]
2023-12-29 Add tolerance to mainboard PCB thickness #27
2023-12-29 Minor change
    [Top.scad]
2023-12-29 Fixed isp fuses
2023-12-30 Added example for LED and button
2023-12-31 Working at middle support
    [CenterBoard.scad, Connector_PinHeader_2_00mm.scad, LeftBoard.scad, MiddleSupportLeft.scad, PinHeader_1x6_P2_00mm_Vertical.scad, ProfileScrewHoles.scad, RGBW-Bar.scad, ScrewHole.scad]
2023-12-31 Refactored directory structure
    [MiddleSupport.scad, MiddleSupportRight.scad]
2023-12-31 Added Drill templates
    [CenterTemplate.scad, MiddleSupportTemplate.scad]
2023-12-31 Fixed template width
    [CenterTemplate.scad, MiddleSupportTemplate.scad]
2024-01-01 Enable 400k I2c
2024-01-01 Disable led strip when before entering bootloader
2024-01-07 Over voltage protection
2024-01-07 Added extra rim around connector of support
    [MiddleSupport.scad]
2024-01-07 Rounding bars in center supports
    [MiddleSupport.scad]
2024-01-07 Improved remote bootloading with multiple devices on a bus
2024-01-07 When switching between work and follow mode locally, send it also to the others on the bus
2024-01-09 Made sliding holes for the middle supports
    [MiddleSupport.scad, ScrewFoot.scad, Support.scad]
2024-01-09 Added plus-sign label to side connectors on case
    [Relief.scad]
2024-01-09 Fixed rendering 'LedBar' with middle supports
    [LedBar.scad]
2024-01-09 Added clearance above 6mm button, so we have space for a button know extension
    [SW_PUSH_6mm.scad]
2024-01-10 Added EndSupports
    [EndSupportStraight.scad, Support.scad]
2024-01-11 Give EndSupports also a sliding foot
    [EndSupportStraight.scad]
2024-01-11 Thicken plus-sign on case top, such that vertical part is printable
    [Relief.scad]
2024-01-11 Added EndSupportAngle45
    [EndSupportAngle45.scad]
2024-01-11 Added ProfileScrewHolesTemplate
    [ProfileScrewHoles.scad, ProfileScrewHolesTemplate.scad]
2024-01-13 Set FACTOR_MAX to a power of 2 such deviding is fast
2024-01-14 Added current measuring
2024-02-08 Moved the feet of the support at the sides
    [ScrewFoot.scad, Support.scad]
2024-03-07 Added button
2024-03-10 Fixed i2c flush
2024-03-10 Refresh all leds strips at the same time
2024-03-15 Fixed led error blinking
    [lightControl.cpp, main.cpp, receiver_errors.cpp]
2024-03-22 Re request to send if sender requests bigger time slot
2024-03-23 Fixed led blink (causes assert at preamble error)
    [leds.cpp, leds.hpp, receiver_errors.cpp, receiver_errors.hpp]
2024-03-23 Fixed sending extended length
    [Main.java]
2024-03-23 Increased time between commands, to prevent commands clashes on the bus
    [Main.java]
2024-03-23 Fixed ledbar in comm-error state loop (Apparently not yet)
    [receiver.cpp, receiver_errors.cpp, receiver_errors.hpp]
2024-03-23 Green led shows light control mode
2024-03-28 In progress, bug not found yet
    [Main.java, command.hpp, receiver.cpp, receiver_errors.cpp, receiver_errors.hpp]
